tothadi/esp-heating-control/hardware/enclosure/drawings/inserts_drawing.pdf

0, 0

## ESP Heating Control – cover (cover.stl) – threaded inserts

VIEW FROM BOTTOM (open side of the cover). 8 × JLC3DP insert Type 5: M3*4*5 (M3, 5 mm long, OD 4.0 mm), hole Ø3.6 mm × 7 mm deep, already in the model. Inserts go into the end faces of the Ø9.8 mm bosses, flush with the face. Corner bosses (H, red): faces 3.6 mm inside the cover rim. Logic
board bosses (LB, purple): inside the nose, faces 38.0 mm deeper than the corner bosses. Positions in mm from the bottom-left corner of this view (0,
0).
H2 | H1

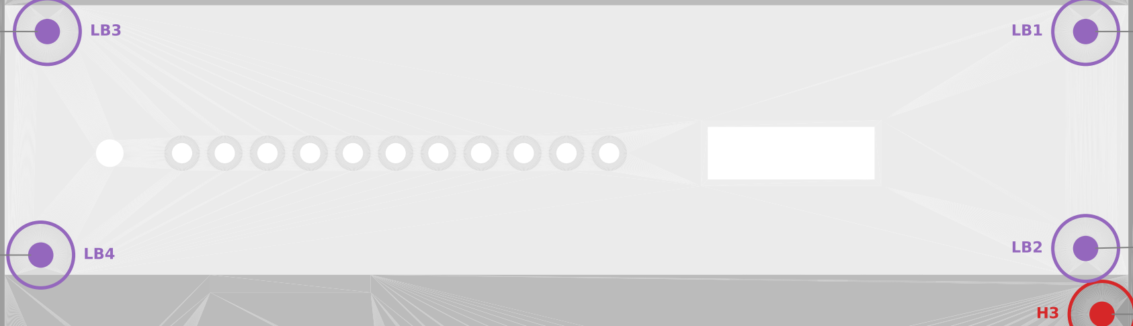
[picture p16: figure]

H4

H4: INSERT TYPE 5 (M3*4*5) corner boss
x 6.0 y 6.0

LB4: INSERT TYPE 5 (M3*4*5) logic board boss
x 7.5 y 27.5

LB3: INSERT TYPE 5 (M3*4*5) logic board boss
x 8.5 y 61.5

H2: INSERT TYPE 5 (M3*4*5) corner boss
x 6.0 y 84.0

H3: INSERT TYPE 5 (M3*4*5) corner boss
x 169.0 y 18.5

LB2: INSERT TYPE 5 (M3*4*5) logic board boss
x 166.5 y 28.5

LB1: INSERT TYPE 5 (M3*4*5) logic board boss
x 166.5 y 61.5

H1: INSERT TYPE 5 (M3*4*5) corner boss
x 169.0 y 84.0
