tothadi/esp-heating-control/hardware/enclosure/drawings/inserts_drawing.png

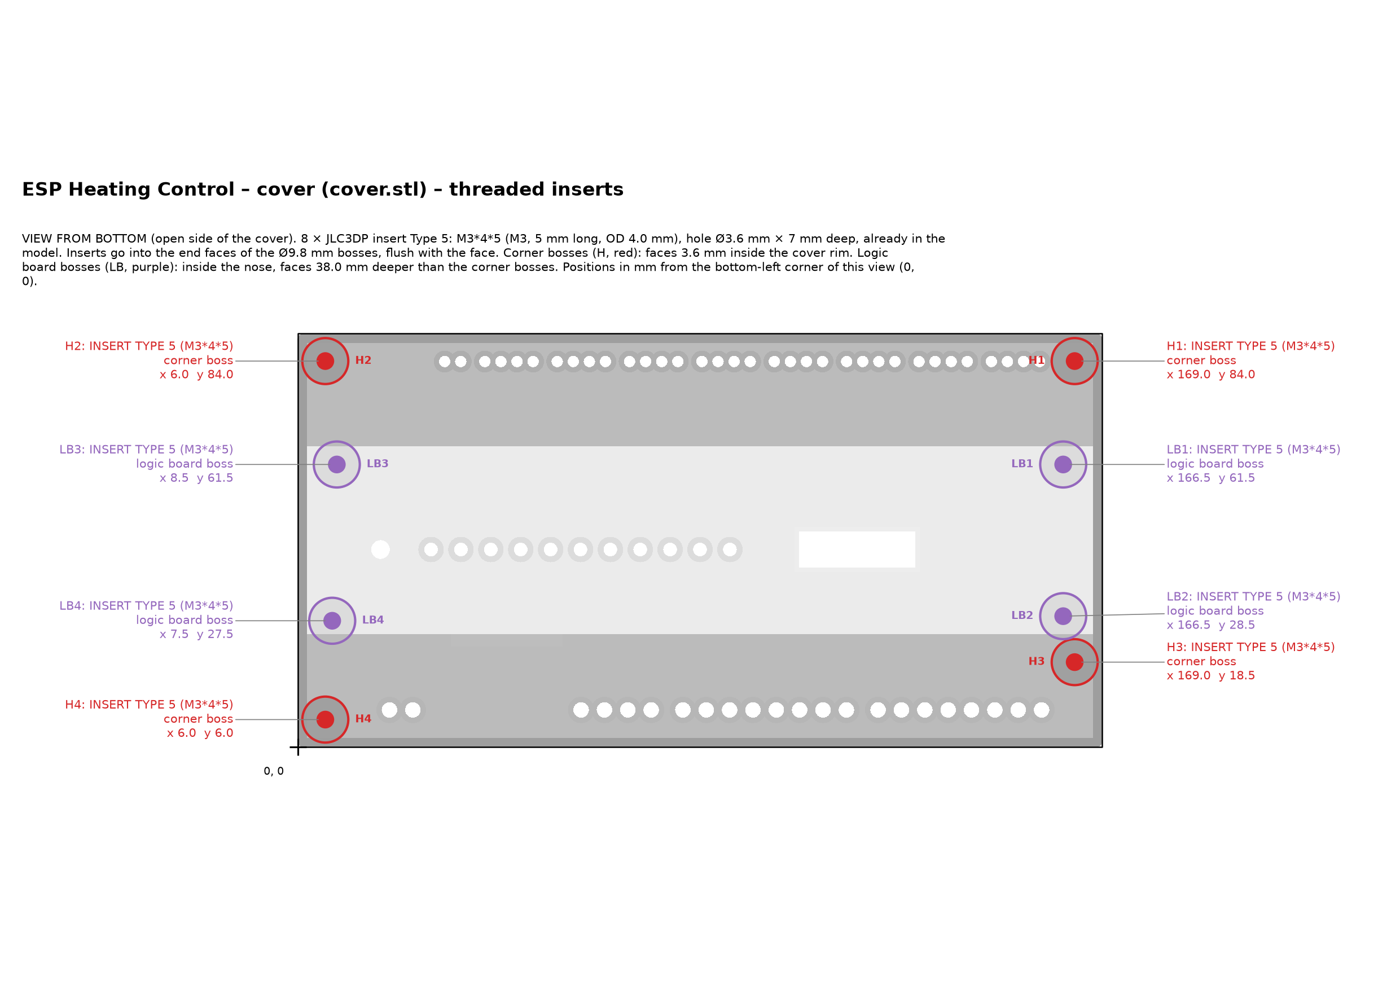
hardware/enclosure/drawings/inserts_drawing.png
