tothadi/esp-heating-control/hardware/renders/asm_boards_ffc_side.png

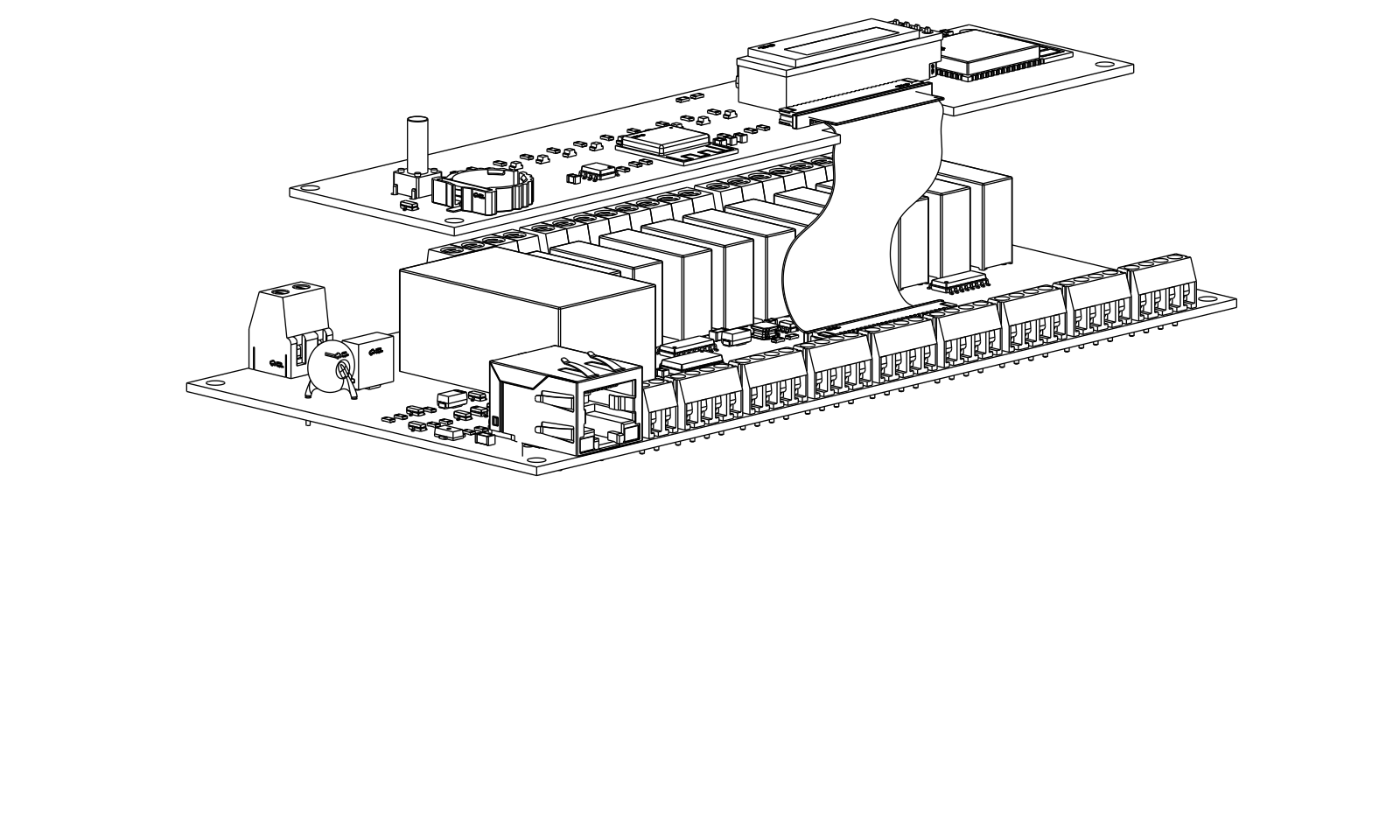
hardware/renders/asm_boards_ffc_side.png
