tothadi/esp-heating-control/hardware/renders/asm_closed_back.png

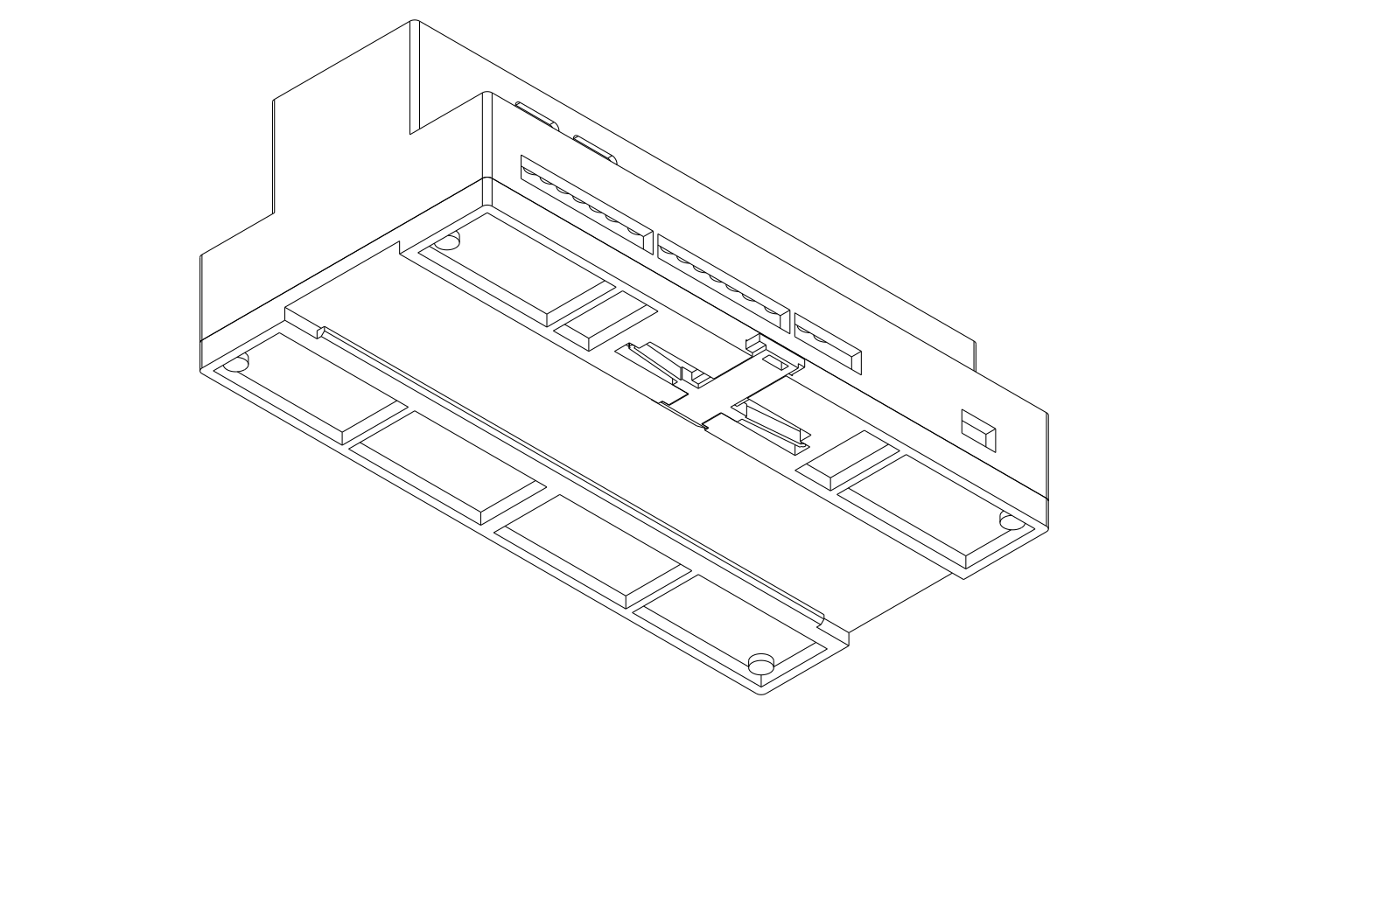
hardware/renders/asm_closed_back.png
