tothadi/esp-heating-control/hardware/renders/asm_closed_front.png

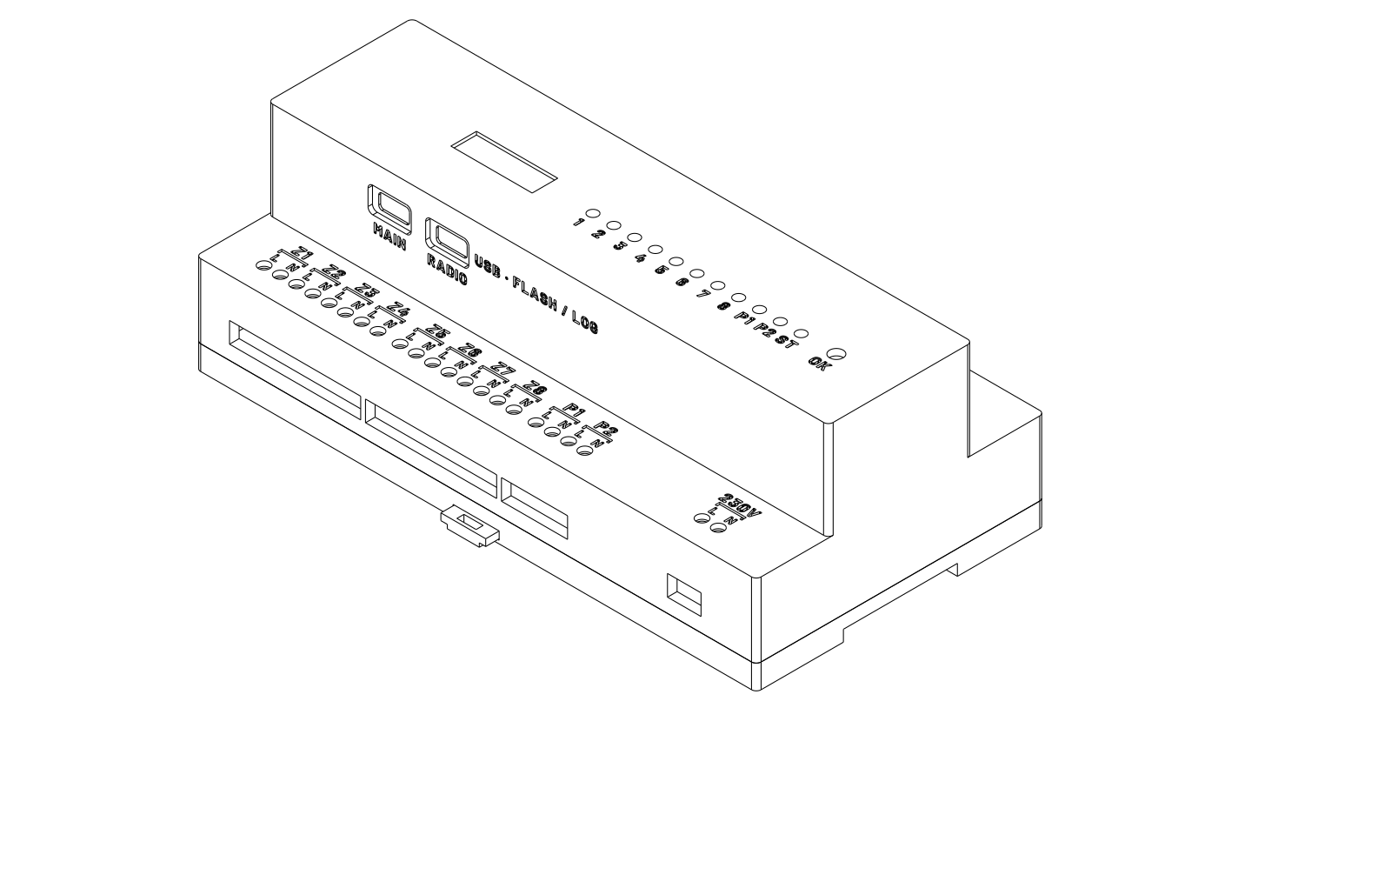
hardware/renders/asm_closed_front.png
