tothadi/esp-heating-control/hardware/renders/asm_closed_side.png

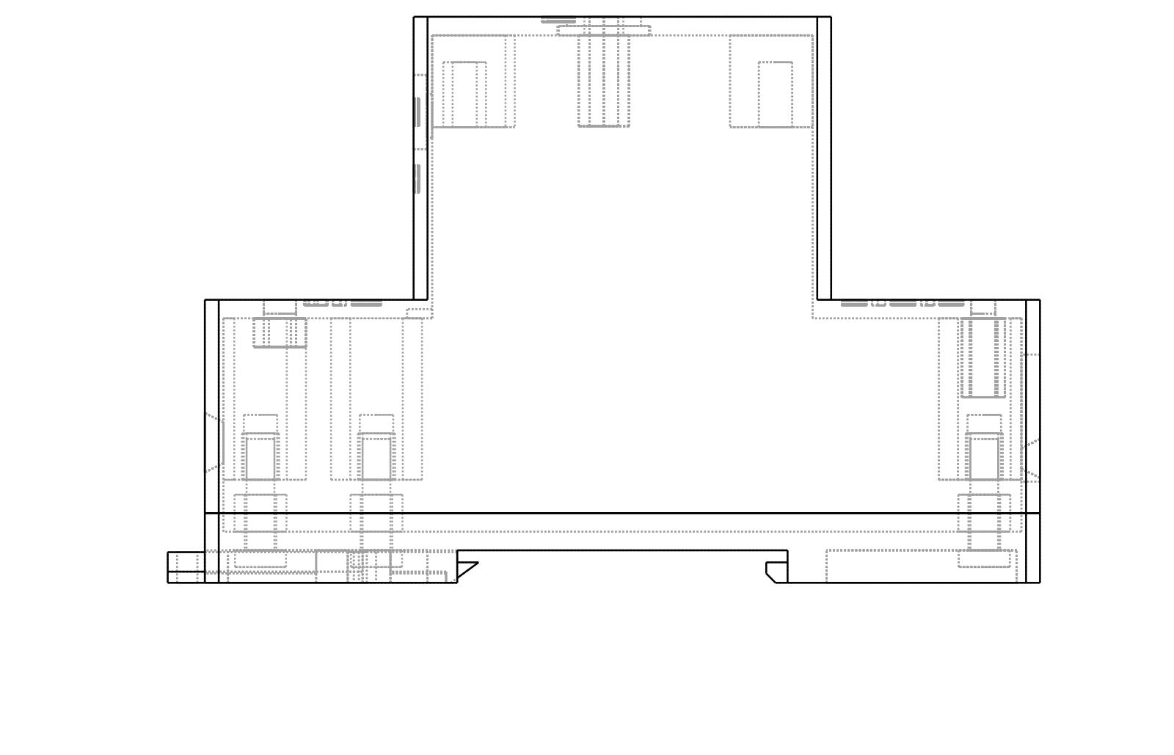
hardware/renders/asm_closed_side.png
