tothadi/esp-heating-control/hardware/renders/asm_closed_top.png

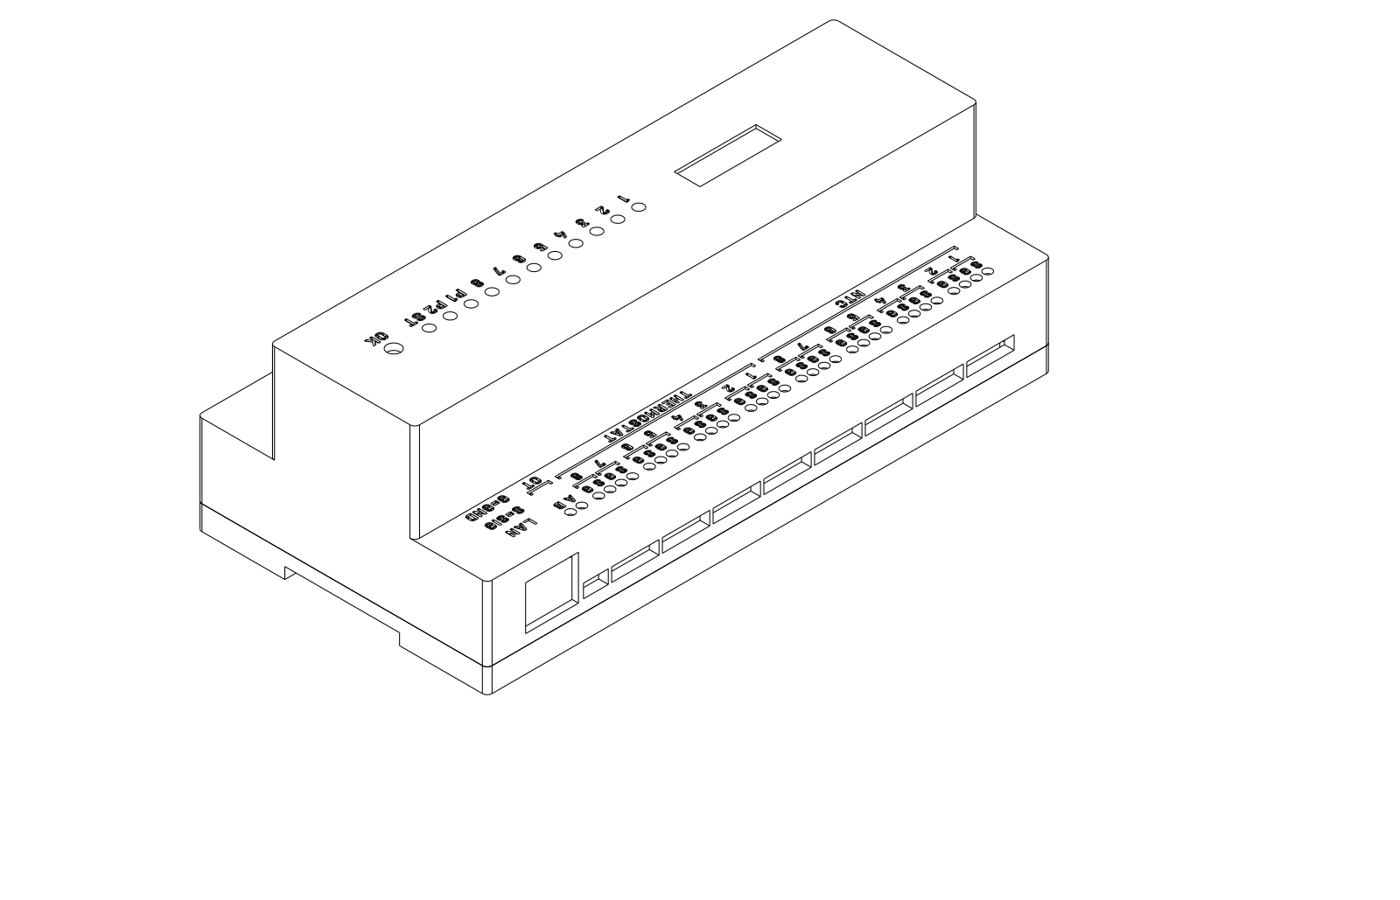
hardware/renders/asm_closed_top.png
