tothadi/esp-heating-control/hardware/renders/asm_din_section.png

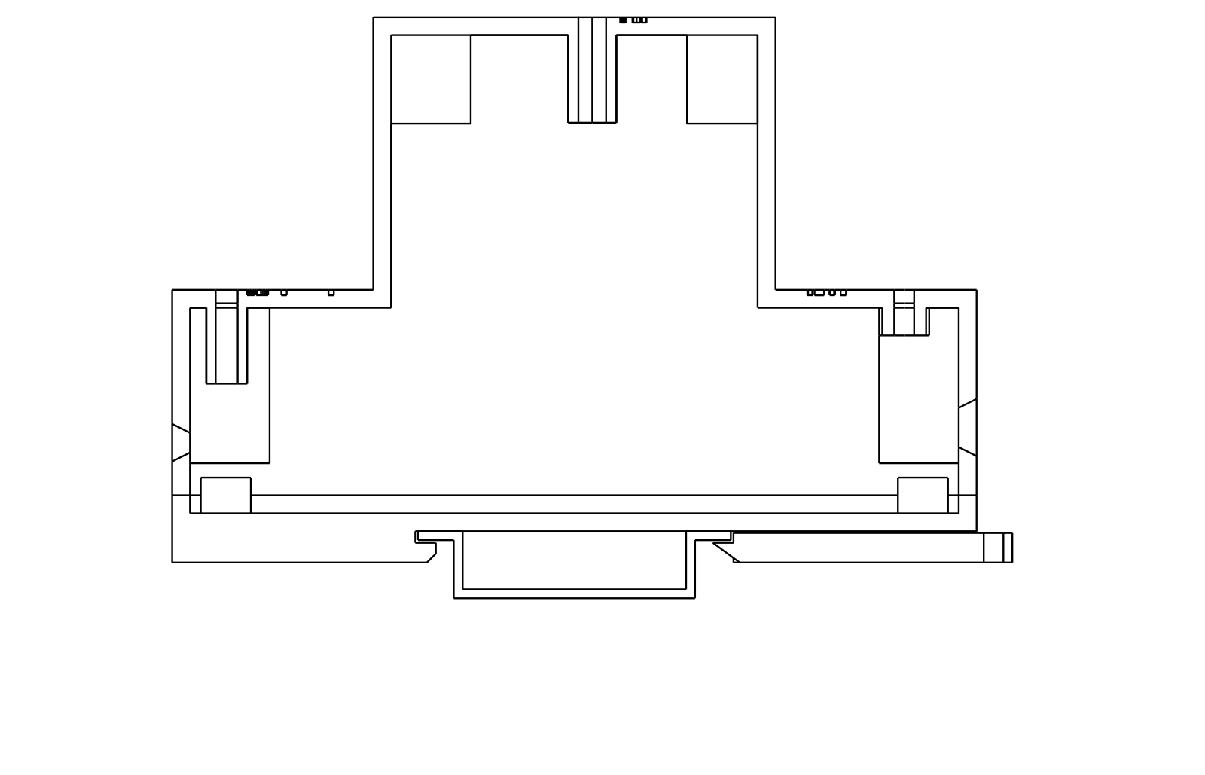
hardware/renders/asm_din_section.png
