tothadi/esp-heating-control/hardware/renders/asm_din_slider.png

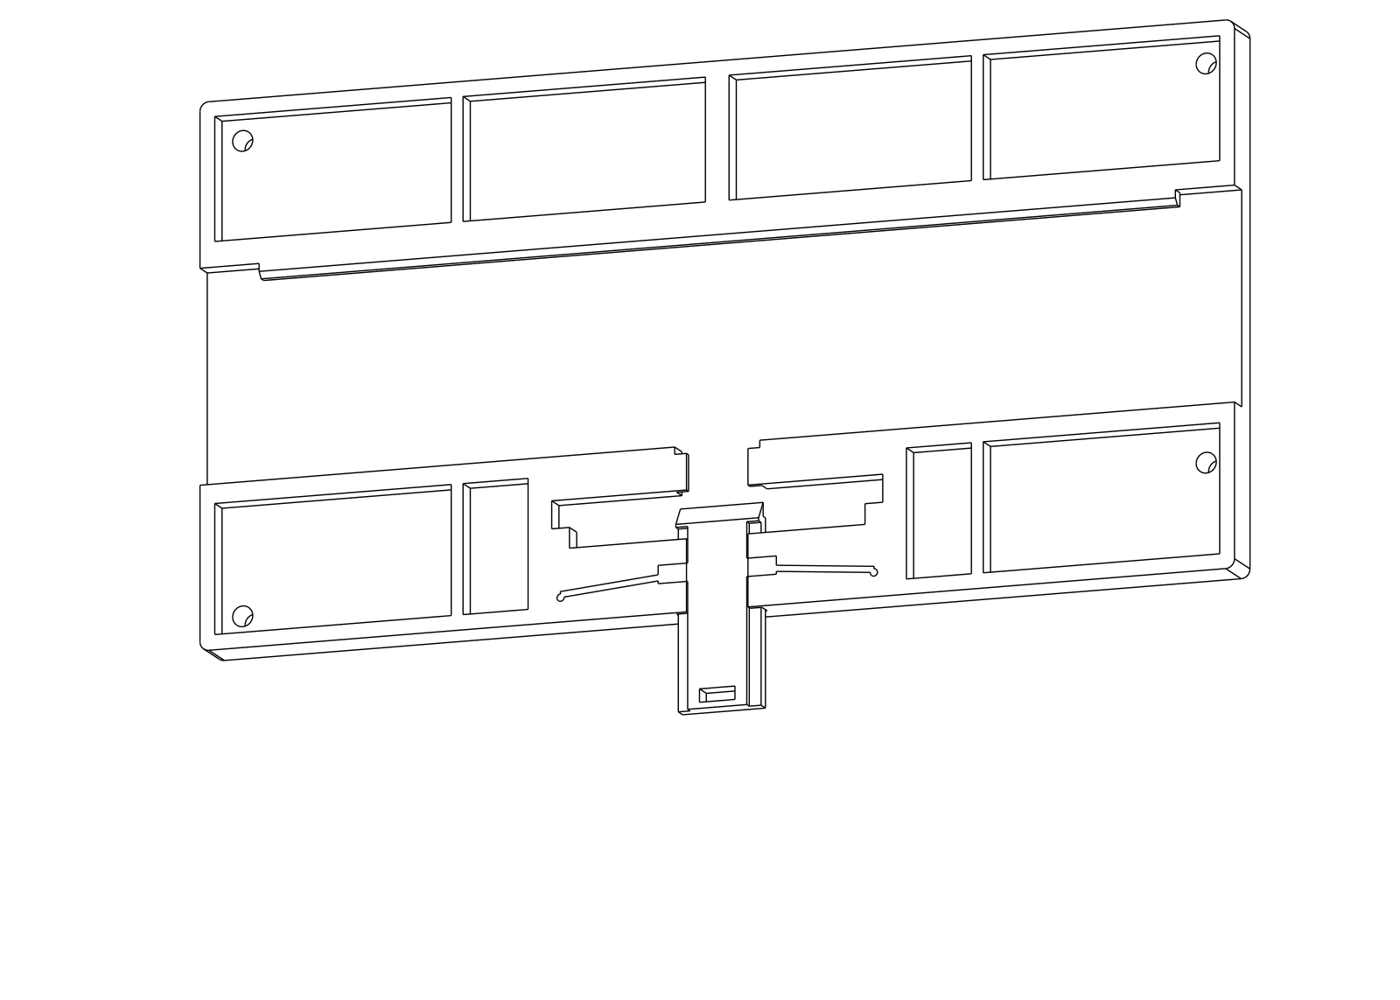
hardware/renders/asm_din_slider.png
