tothadi/esp-heating-control/hardware/renders/asm_led_section.png

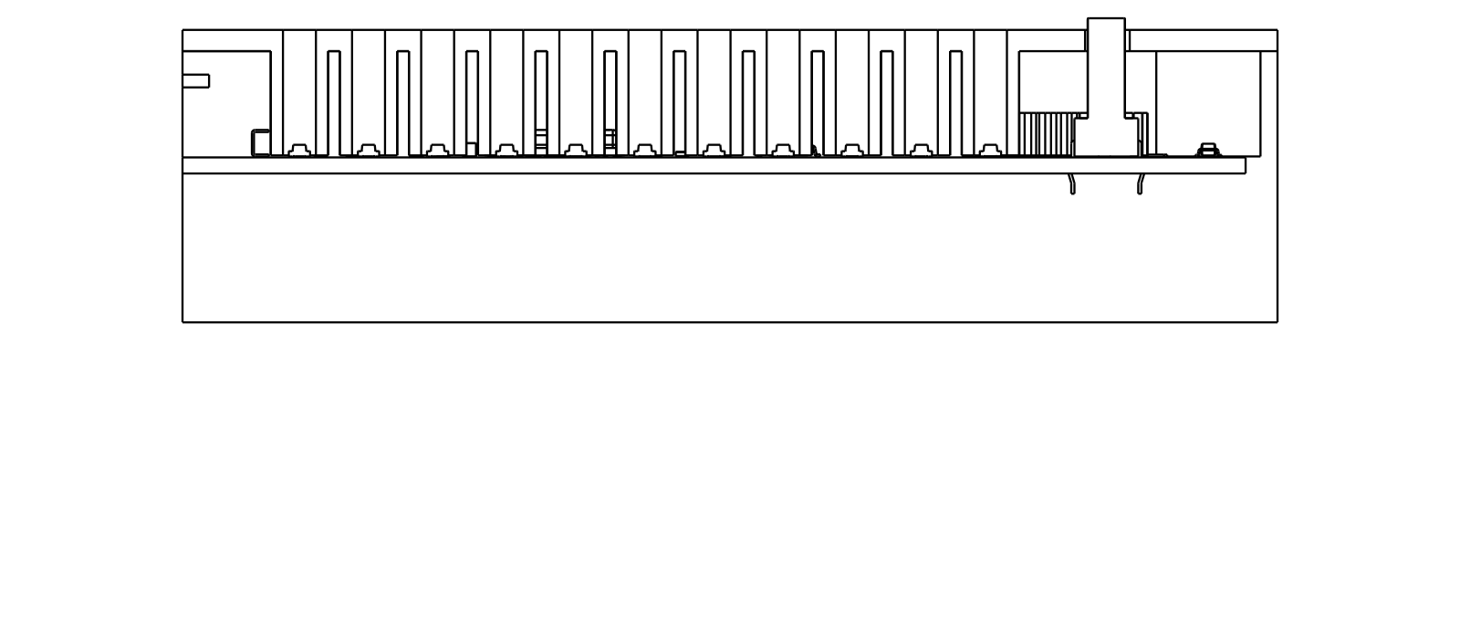
hardware/renders/asm_led_section.png
