tothadi/esp-heating-control/hardware/renders/asm_oled_section.png

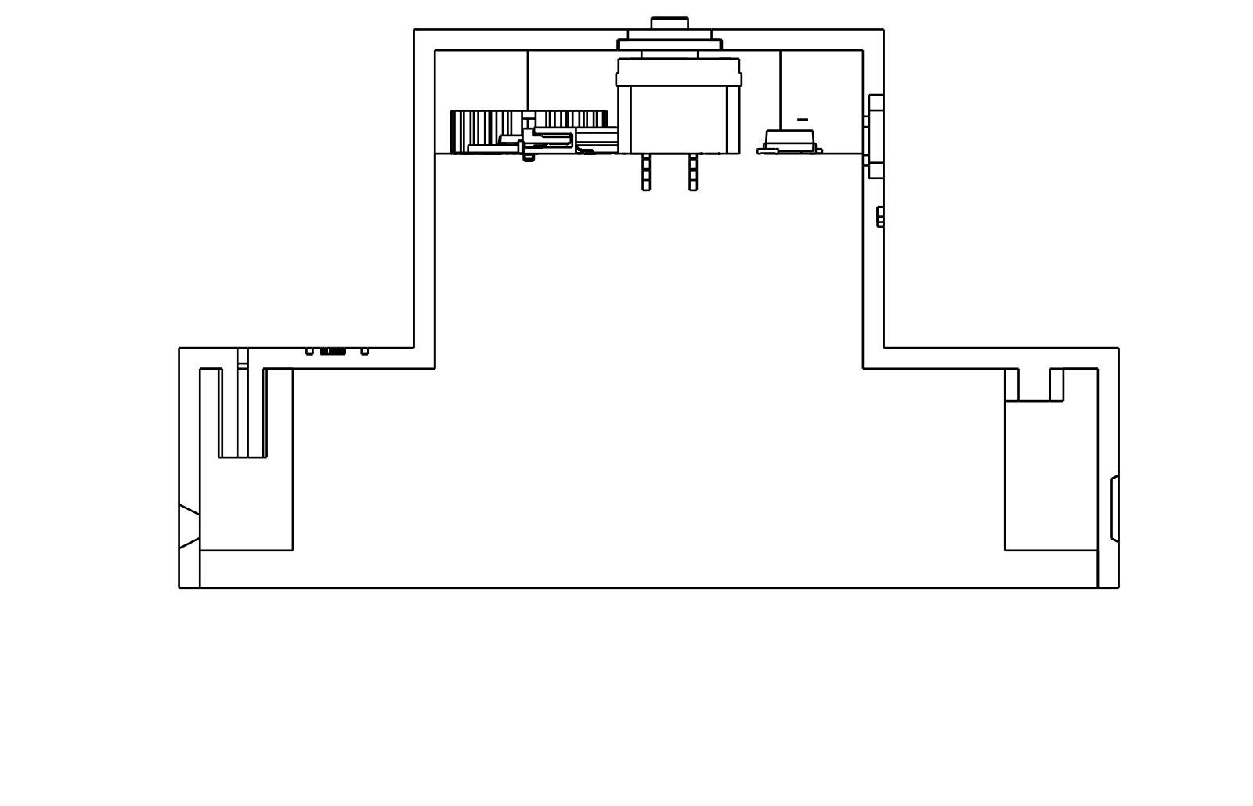
hardware/renders/asm_oled_section.png
