tothadi/esp-heating-control/hardware/renders/logic_bottom.png

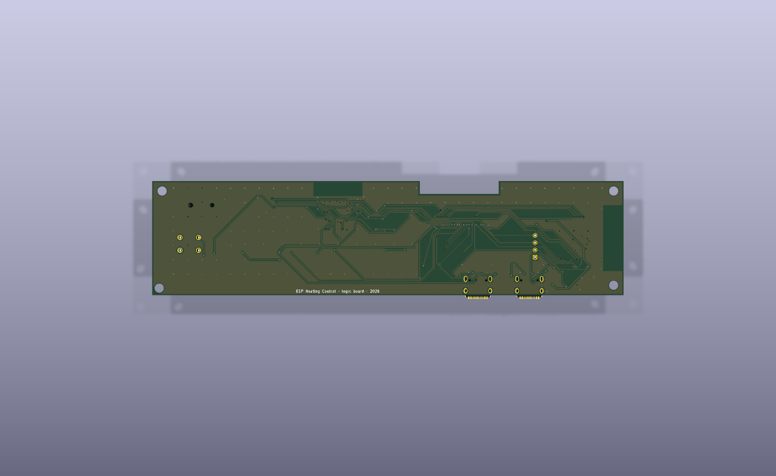
hardware/renders/logic_bottom.png
