tothadi/esp-heating-control/hardware/renders/logic_iso_bottom.png

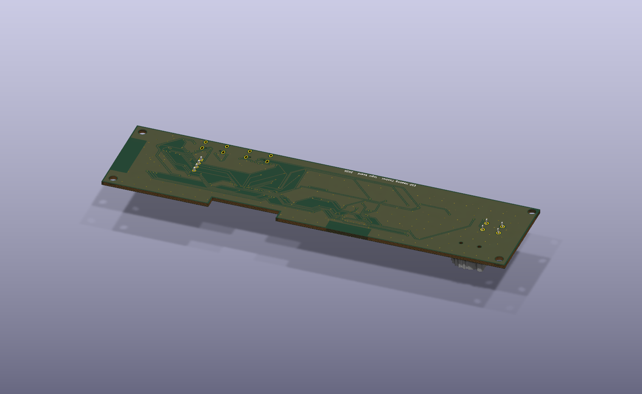
hardware/renders/logic_iso_bottom.png
