tothadi/esp-heating-control/hardware/renders/lower_bottom.png

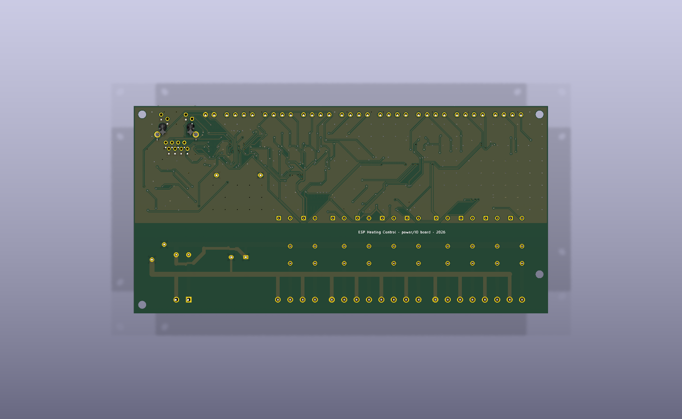
hardware/renders/lower_bottom.png
