tothadi/esp-heating-control/hardware/renders/lower_iso_back.png

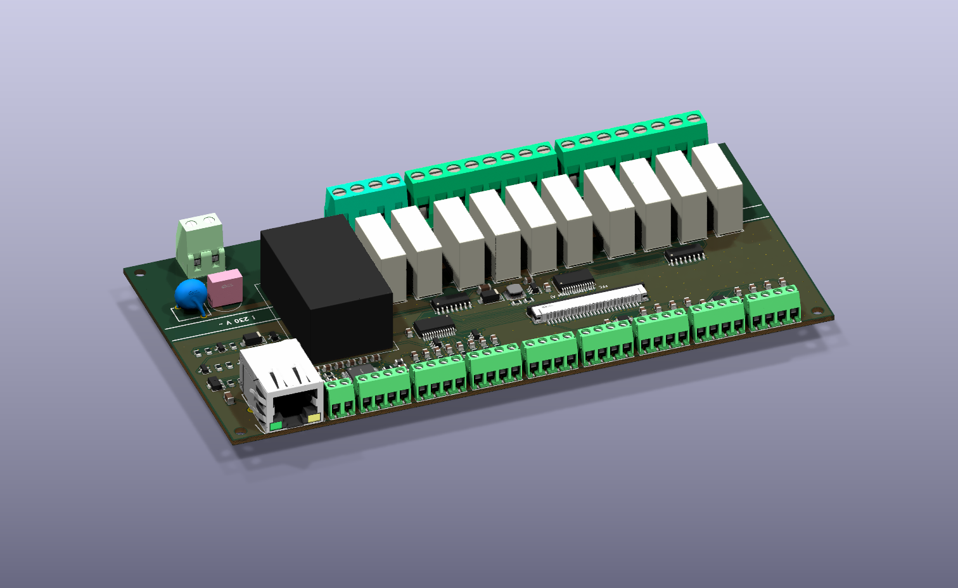
hardware/renders/lower_iso_back.png
