tothadi/esp-heating-control/hardware/pcb/logic/fab/jlcpcb_bom.csv

Comment | Designator | Footprint | LCSC Part #
BS-12-B2AA002 (CR1220) | BT1 | BS-12 | C964721
10uF 25V X5R | C40,C41,C48 | C_0805 | C15850
100nF 50V X7R | C43,C45,C49 | C_0805 | C49678
1uF 50V X7R | C44,C50 | C_0805 | C28323
22uF 25V X5R | C47 | C_0805 | C45783
SS34 | D1,D2 | D_SMA | C8678
BAT54S | D14 | SOT-23 | C7420333
LED green 0805 | D20,D21,D22,D23,D24,D25,D26,D27 | LED_0805 | C2297
LED yellow 0805 | D28,D29 | LED_0805 | C2296
LED red 0805 | D30 | LED_0805 | C84256
AFA07-S26FCA-00 FFC 26P 1.0mm | J1 | JUSHUO_AFA07-S26FCA-00 | C2681942
TYPE-C-31-M-12 | J2,J4 | USB-C-16P | C165948
PZ254V-11-04P pin header 1x4 2.54mm (OLED) | J3 | HDR-1x4-P2.54-V | C492403
4.7k 1% | R9,R10,R28,R29 | R_0805 | C17673
10k 1% | R17,R19,R20,R25,R26,R27 | R_0805 | C17414
5.1k 1% | R21,R22,R23,R24 | R_0805 | C27834
330R 1% | R50,R51,R52,R53,R54,R55,R56,R57,R58,R59,R60 | R_0805 | C17630
KH-6X6X13H-TJ | SW1 | 6x6 H13 | C2837523
ESP32-S3-WROOM-1-N16R8 | U1 | ESP32-S3-WROOM-1 | C2913202
AMS1117-3.3 | U2 | SOT-223 | C6186
DS3231MZ+TRL | U6 | SOIC-8 | C107410
ESP32-H2-MINI-1-H4S | U7 | ESP32-H2-MINI-1 | C47967030
