tothadi/esp-heating-control/hardware/pcb/lower/fab/jlcpcb_bom.csv

Comment | Designator | Footprint | LCSC Part #
100nF 50V X7R | C1,C4,C11,C19,C29,C30,C31,C32,C33,C34,C35,C36,C37,C73,C77,C80,C81,C82 | C_0805_2012Metric | C49678
10uF 25V X5R | C10,C21,C22,C23,C24,C25,C26,C27,C28,C40,C85 | C_0805_2012Metric | C15850
220uF 16V 6.3x7.7 (RVT1C221M0607) | C12 | CP_Elec_6.3x7.7 | C970695
10uF 50V X5R 1206 | C41 | C_1206 | C13585
22nF X7R 50V | C70 | C_0805 | C1729
6.8nF X7R 50V | C71,C72 | C_0805 | C1755
1nF 2kV X7R 1206 | C74 | C_1206 | C9196
18pF C0G 50V | C75,C76 | C_0805 | C1797
10nF X7R 50V | C83 | C_0805 | C1710
4.7uF X5R 25V | C84 | C_0805 | C1779
SS34 | D20 | D_SMA | C8678
BZT52C4V3 | D21 | SOD-123 | C19077399
BAT54S | D22,D23 | SOT-23 | C7420333
SMAJ24A | D24 | D_SMA | C19077541
T2A 250V TR5 (2010T2A250V) | F1 | Fuse_Littelfuse_372_D8.50mm | C354902
Ferrite 600R@100MHz 500mA | FB1 | 0805 | C1017
XY350V-3.5-4P screw terminal | J1,J2,J3,J4,J5,J6,J7,J8 | XY350V-3.5-4P | C557656
XY350V-3.5-2P screw terminal | J9 | XY350V-3.5-2P | C784942
DB128V-5.08-8P-GN-S screw terminal | J21,J22 | DB128V-5.08-8P | C5143711
DB128V-5.08-4P-GN-S screw terminal | J23 | DB128V-5.08-4P | C2915641
DB128V-5.08-2P-GN-S screw terminal | J24 | DB128V-5.08-2P | C2915639
AFA07-S26FCA-00 FFC 26P 1.0mm | J30 | JUSHUO_AFA07-S26FCA-00 | C2681942
J1B1211CCD RJ45 10/100 magjack | J40 | RJ45-TH_J1B1211CCD | C910371
G5NB-1A-E-DC5V | K1,K2,K3,K4,K5,K6,K7,K8,K9,K10 | Relay_SPST_Omron_G5NB | C48746
22uH SWPA4030S220MT | L1 | 4x4 | C83472
HLK-5M05 | PS1 | Converter_ACDC_Hi-Link_HLK-5Mxx | C209907
BCX56-16,115 (Nexperia) | Q1 | SOT-89 | C100026
MMBT3904 | Q2,Q3,Q4 | SOT-23 | C20526
10k 0.1% | R21,R22,R23,R24,R25,R26,R27,R28 | R_0805 | C110775
1k 1% | R30,R31,R32,R33,R34,R35,R36,R37,R40,R41,R42,R43,R44,R45,R46,R47,R56,R59 | R_0805 | C17513
390k 1% | R50 | R_0805 | C17656
10k 1% | R51,R54,R57,R84 | R_0805 | C17414
2.2k 1% 1206 | R52 | R_1206 | C17948
68k 1% | R53 | R_0805 | C17801
15R 1% | R55 | R_0805 | C17480
47R 1% | R58 | R_0805 | C17714
4.7k 1% | R60 | R_0805 | C17673
3.3R 1% | R70,R71,R75,R76 | R_0805 | C2907250
49.9R 1% | R72,R73,R77,R78 | R_0805 | C17720
10R 1% | R74 | R_0805 | C17415
12.4k 1% | R79 | R_0805 | C30908
470R 1% | R80,R81 | R_0805 | C17710
1M 1% | R82 | R_0805 | C17514
0R | R83 | R_0805 | C17477
07D471K | RV1 | RES-TH_L9.0-W6.2-P5.00-D0.7-S6.20 | C28756
MCP23017-E/SS | U1,U14 | SSOP-28_5.3x10.2mm_P0.65mm | C506653
ULN2003A | U2,U3 | SOIC-16_3.9x9.9mm_P1.27mm | C688859
ADS1115IDGSR | U10,U11 | MSOP-10 | C37593
SRV05-4 | U12,U13 | SOT-23-6 | C13612
MT3608 | U20 | SOT-23-6 | C84817
CJ431 | U21 | SOT-23 | C3113
W5500 | U30 | LQFP-48 | C32843
25MHz 12pF X322525MOB4SI | Y30 | 3225 | C9006
