tothadi/esp-heating-control/hardware/enclosure/models/cover.stl

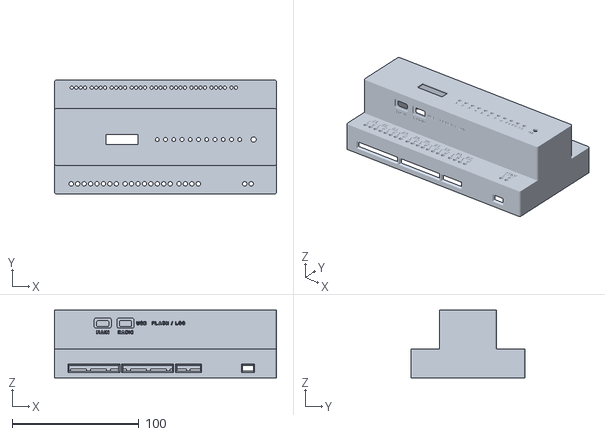
[picture p31: CAD file, 2026-11-10]
hardware/enclosure/models/cover.stl
175.0 x 90.0 x 53.5
