tothadi/esp-heating-control/hardware/pcb/components/3d-models/LQFP-48_L7.0-W7.0-H1.4-LS9.0-P0.50.step

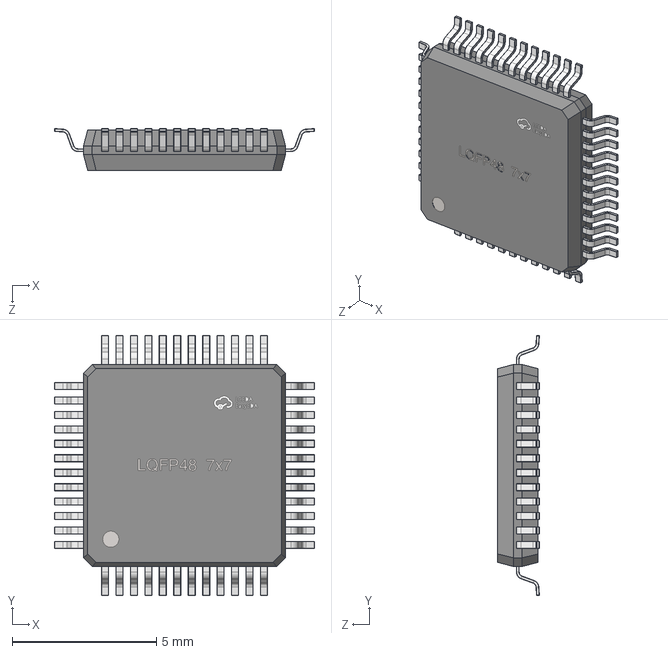
[picture p32: CAD file, 2026-11-10]
hardware/pcb/components/3d-models/LQFP-48_L7.0-W7.0-H1.4-LS9.0-P0.50.step
9.01 x 9.01 x 1.45 mm
