tothadi/esp-heating-control/hardware/enclosure/models/oled_window.dxf

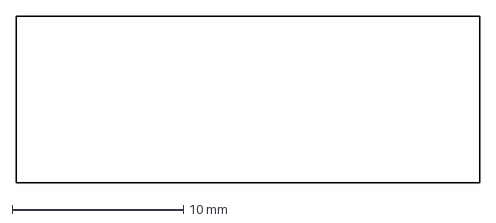
[picture p33: CAD file, 2026-11-10]
hardware/enclosure/models/oled_window.dxf
27.1 x 9.70 mm
