tothadi/esp-heating-control/hardware/pcb/components/3d-models/RJ45-TH_J1B1211CCD.step

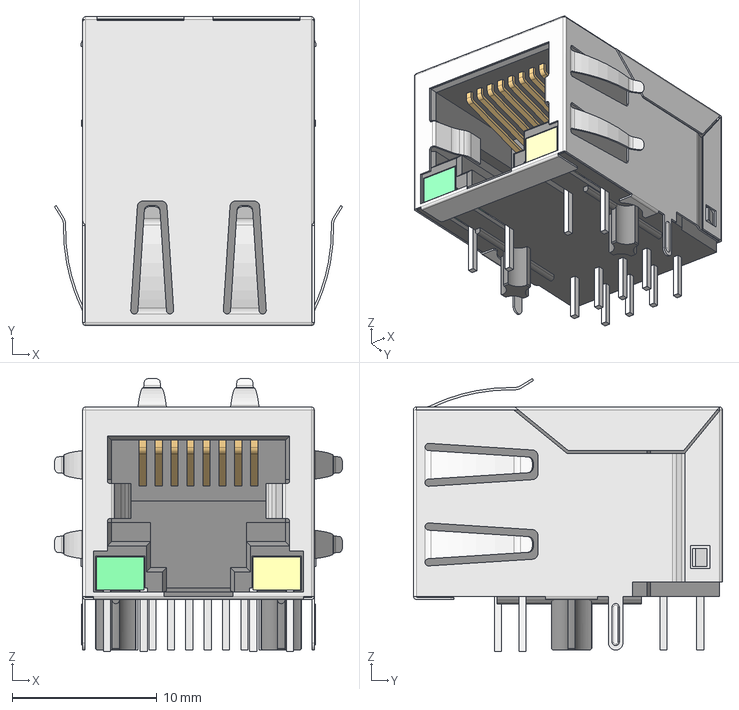
[picture p34: CAD file, 2026-11-10]
hardware/pcb/components/3d-models/RJ45-TH_J1B1211CCD.step
19.9 x 21.4 x 18.9 mm
