tothadi/esp-heating-control/hardware/enclosure/models/base.stl

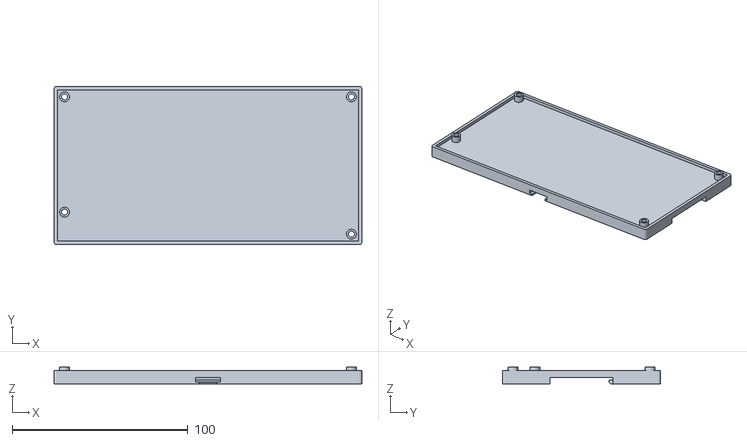
[picture p35: CAD file, 2026-11-10]
hardware/enclosure/models/base.stl
175.0 x 90.0 x 9.50
