tothadi/esp-heating-control/hardware/pcb/components/3d-models/FUSE-TH_L8.5-W4.0-H8.5-P5.08.step

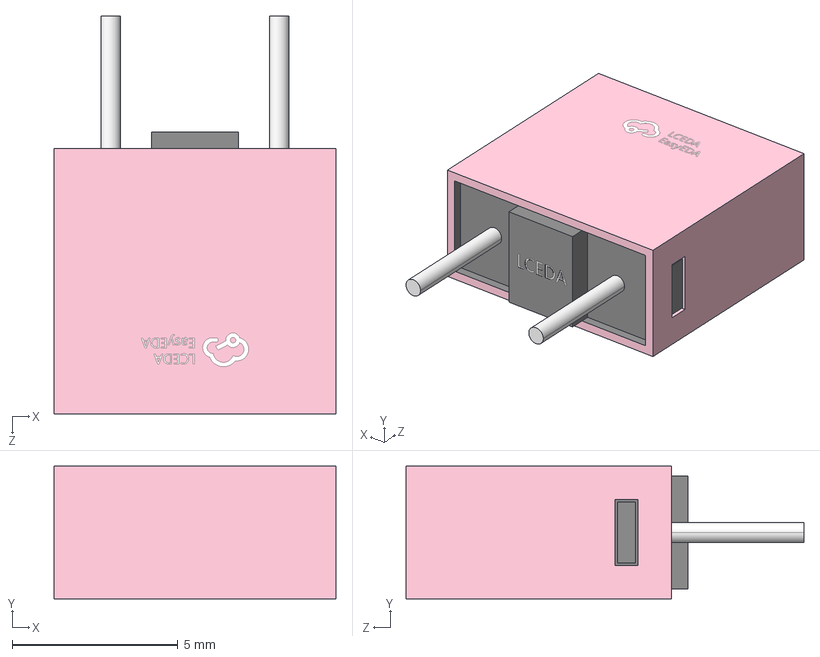
[picture p36: CAD file, 2026-11-10]
hardware/pcb/components/3d-models/FUSE-TH_L8.5-W4.0-H8.5-P5.08.step
8.50 x 4.00 x 12.0 mm
