tothadi/esp-heating-control/hardware/enclosure/models/led_rods.stl

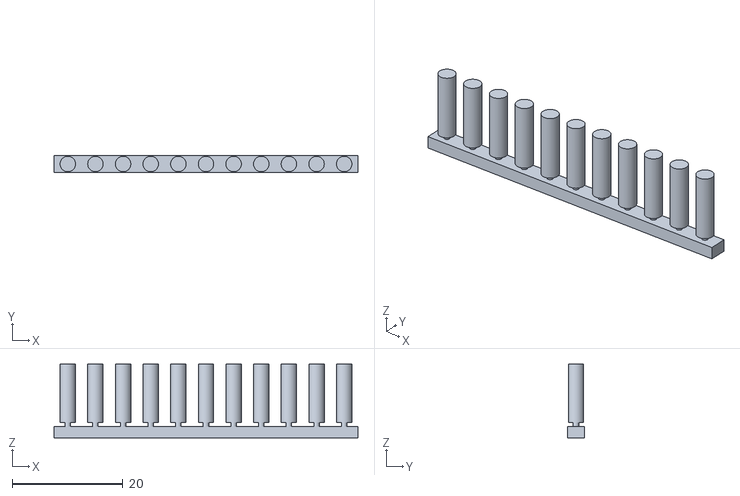
[picture p37: CAD file, 2026-11-10]
hardware/enclosure/models/led_rods.stl
55.0 x 3.00 x 13.3
