tothadi/esp-heating-control/hardware/pcb/components/3d-models/RES-TH_L9.0-W6.2-P5.00-D0.7-S6.20.step

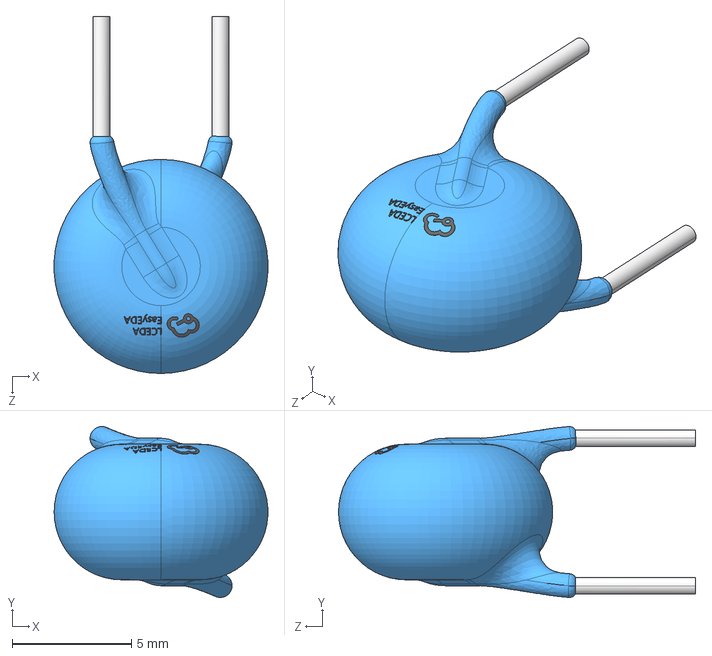
[picture p38: CAD file, 2026-11-10]
hardware/pcb/components/3d-models/RES-TH_L9.0-W6.2-P5.00-D0.7-S6.20.step
8.98 x 7.19 x 15.0 mm
