tothadi/esp-heating-control/hardware/enclosure/models/enclosure.step

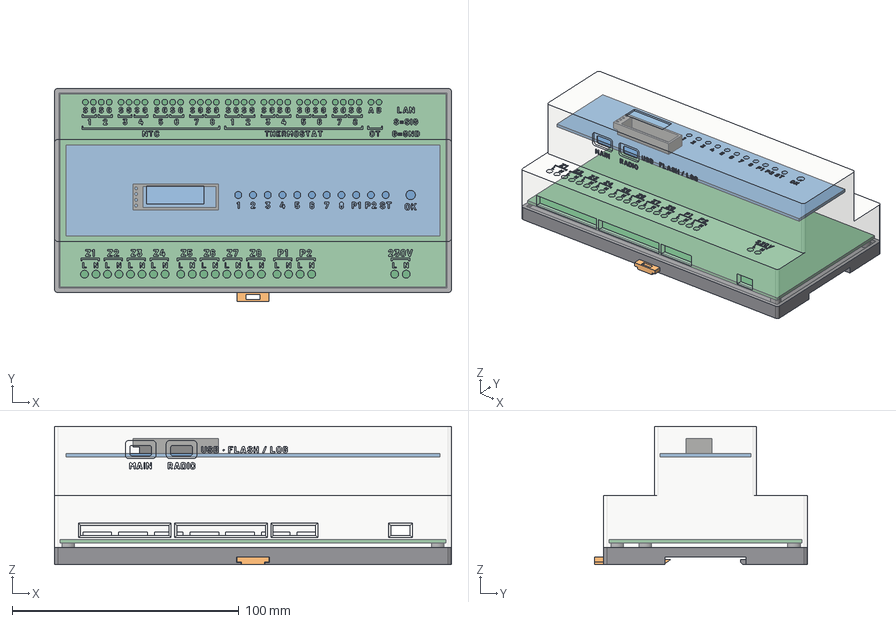
[picture p39: CAD file, 2026-11-10]
hardware/enclosure/models/enclosure.step
175.0 x 94.0 x 61.0 mm
base
din_slider
oled_spacer
oled_window
cover
lower_pcb
upper_pcb
