tothadi/esp-heating-control/hardware/pcb/components/3d-models/CRYSTAL-SMD_4P-L3.2-W2.5-BL.step

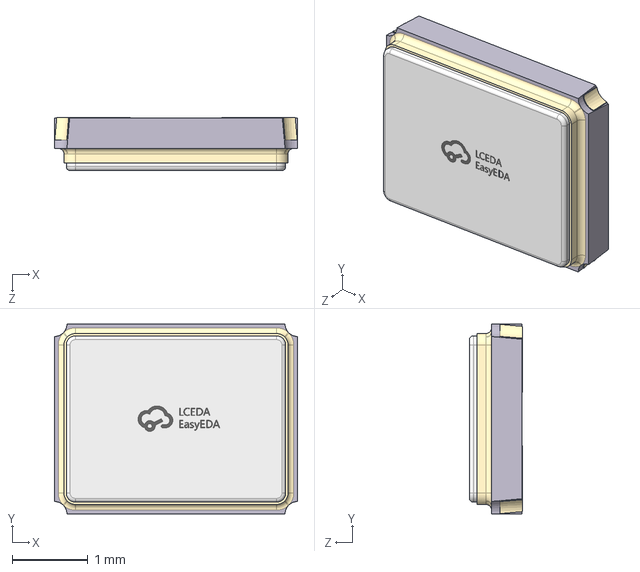
[picture p40: CAD file, 2026-11-10]
hardware/pcb/components/3d-models/CRYSTAL-SMD_4P-L3.2-W2.5-BL.step
3.20 x 2.50 x 0.701 mm
