tothadi/esp-heating-control/hardware/enclosure/models/oled_spacer.stl

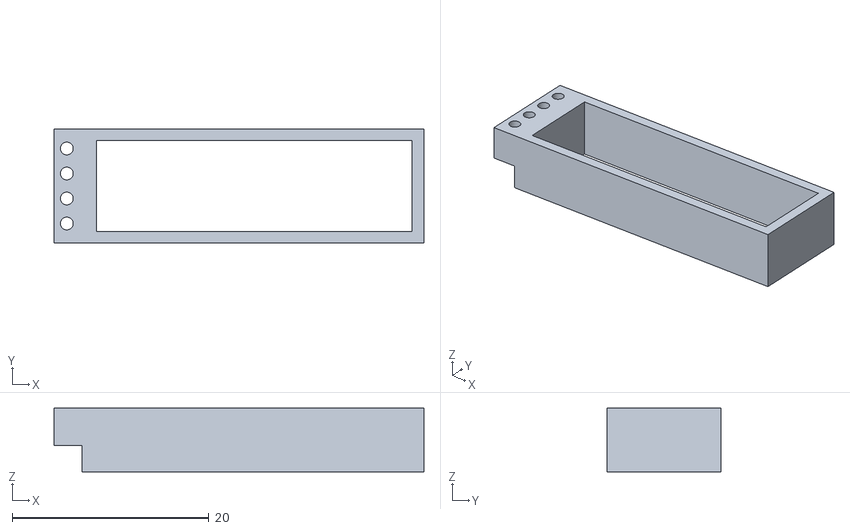
[picture p41: CAD file, 2026-11-10]
hardware/enclosure/models/oled_spacer.stl
37.6 x 11.6 x 6.50
