tothadi/esp-heating-control/hardware/pcb/components/3d-models/WIRELM-SMD_ESP32-H2-MINI-1-H4.step

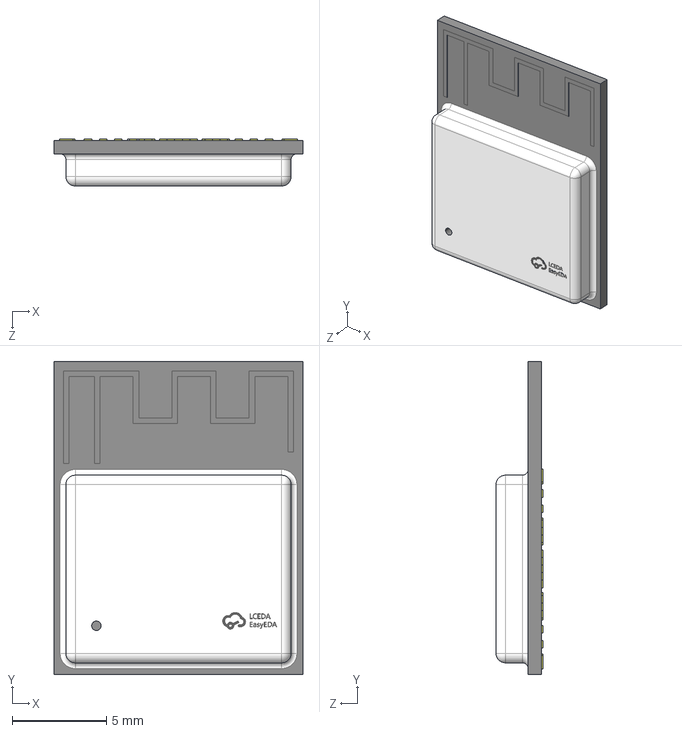
[picture p42: CAD file, 2026-11-10]
hardware/pcb/components/3d-models/WIRELM-SMD_ESP32-H2-MINI-1-H4.step
13.2 x 16.6 x 2.51 mm
