tothadi/esp-heating-control/hardware/enclosure/models/din_slider.stl

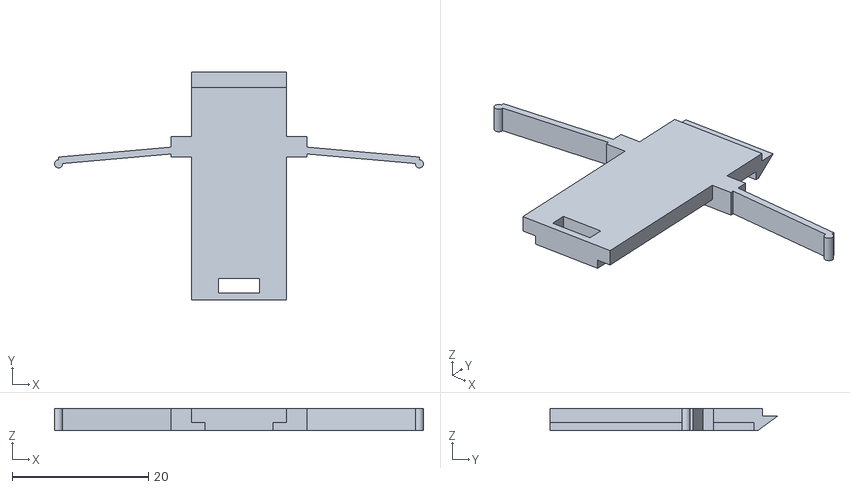
[picture p43: CAD file, 2026-11-10]
hardware/enclosure/models/din_slider.stl
54.2 x 33.5 x 3.30
