tothadi/esp-heating-control/hardware/pcb/components/3d-models/IDC-TH_26P-P2.54_C9040.step

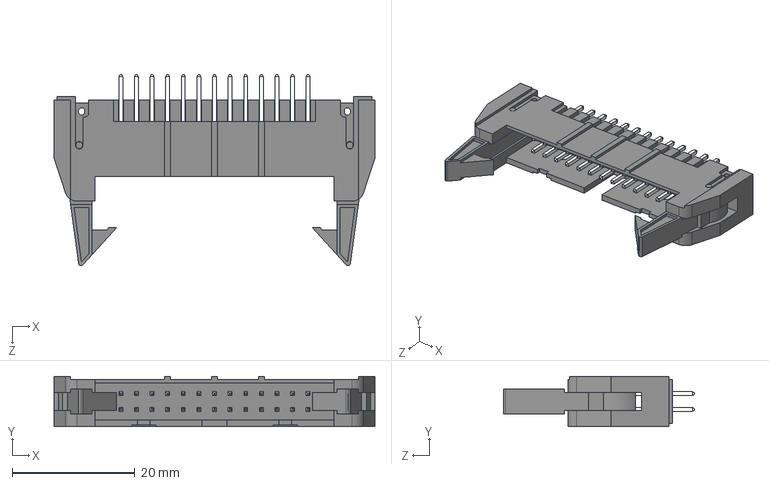
[picture p44: CAD file, 2026-11-10]
hardware/pcb/components/3d-models/IDC-TH_26P-P2.54_C9040.step
52.2 x 8.20 x 31.2 mm
