tothadi/esp-heating-control/hardware/pcb/components/3d-models/BAT-SMD_L28.5-W16.0-H5.5-LS31.3_CR2032-BS-6-1.step

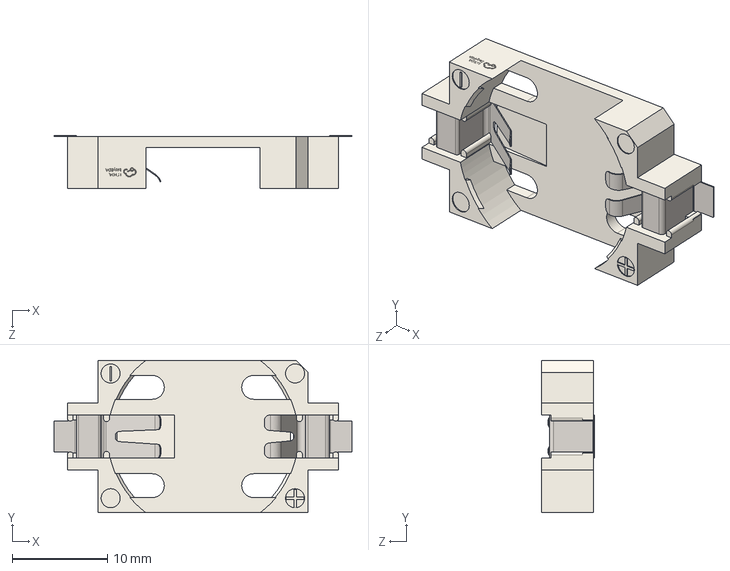
[picture p45: CAD file, 2026-11-10]
hardware/pcb/components/3d-models/BAT-SMD_L28.5-W16.0-H5.5-LS31.3_CR2032-BS-6-1.step
31.3 x 16.0 x 5.60 mm
