tothadi/esp-heating-control/hardware/pcb/components/3d-models/CONN-TH_8P-P5.08_KF2EDGR-5.08-8P.step

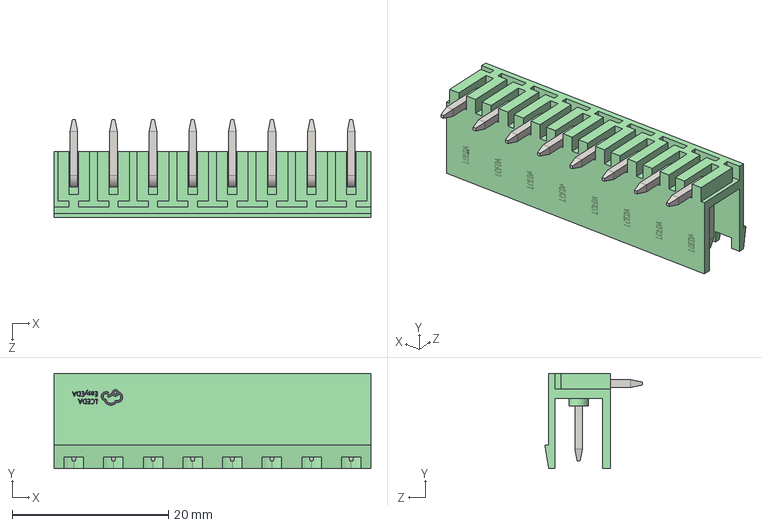
[picture p46: CAD file, 2026-11-10]
hardware/pcb/components/3d-models/CONN-TH_8P-P5.08_KF2EDGR-5.08-8P.step
40.6 x 12.2 x 12.5 mm
