tothadi/esp-heating-control/hardware/pcb/components/3d-models/USB-C_SMD-TYPE-C-31-M-12_1.step

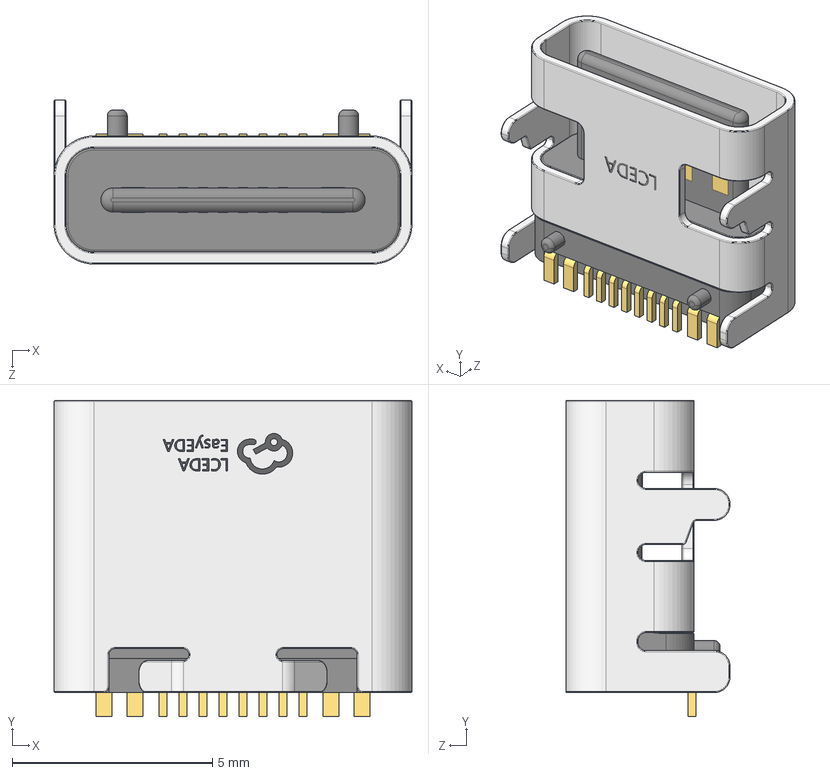
[picture p47: CAD file, 2026-11-10]
hardware/pcb/components/3d-models/USB-C_SMD-TYPE-C-31-M-12_1.step
8.94 x 7.90 x 4.10 mm
