tothadi/esp-heating-control/hardware/pcb/components/3d-models/CONN-TH_XY350V-3.5-4P.step

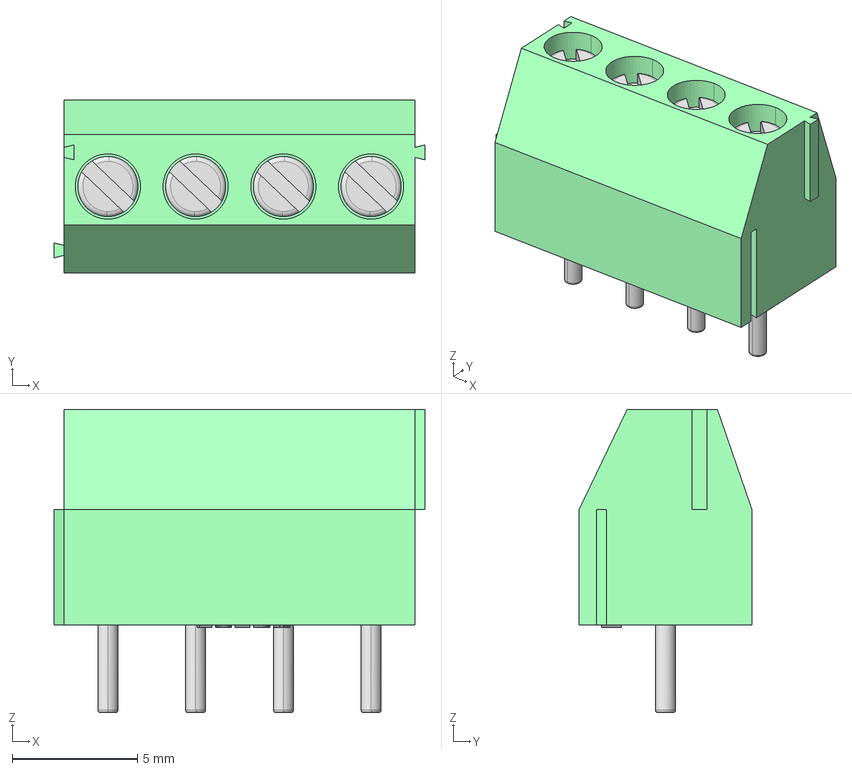
[picture p48: CAD file, 2026-11-10]
hardware/pcb/components/3d-models/CONN-TH_XY350V-3.5-4P.step
14.8 x 6.90 x 12.1 mm
