tothadi/esp-heating-control/hardware/pcb/components/3d-models/SW-TH_4P-L6.0-W6.0-H5.0-LS6.5-P4.50.step

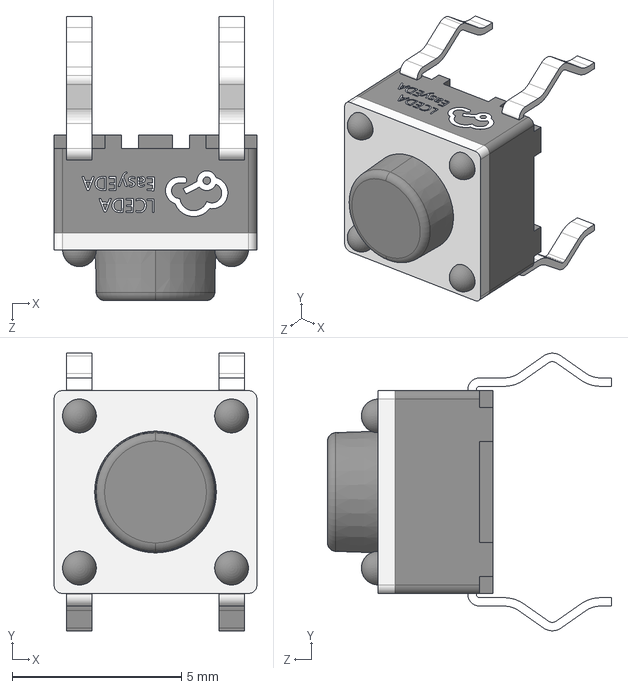
[picture p49: CAD file, 2026-11-10]
hardware/pcb/components/3d-models/SW-TH_4P-L6.0-W6.0-H5.0-LS6.5-P4.50.step
6.00 x 8.21 x 8.40 mm
