tothadi/esp-heating-control/hardware/pcb/components/3d-models/BAT-SMD_BS-12-B2AA002.step

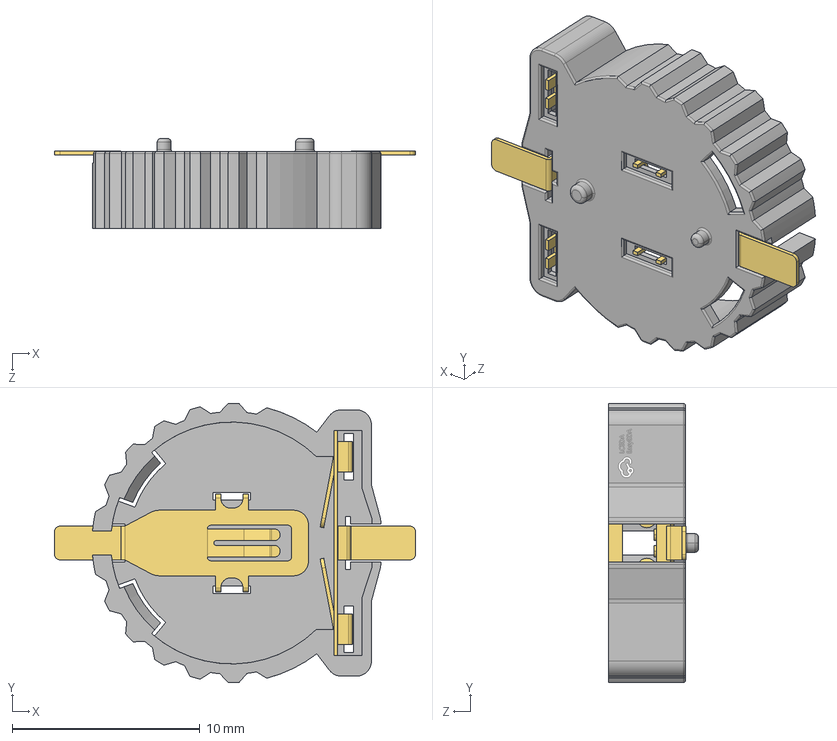
[picture p50: CAD file, 2026-11-10]
hardware/pcb/components/3d-models/BAT-SMD_BS-12-B2AA002.step
19.3 x 14.9 x 4.80 mm
