tothadi/esp-heating-control/hardware/pcb/components/3d-models/HDR-TH_4P-P2.54-V-F.step

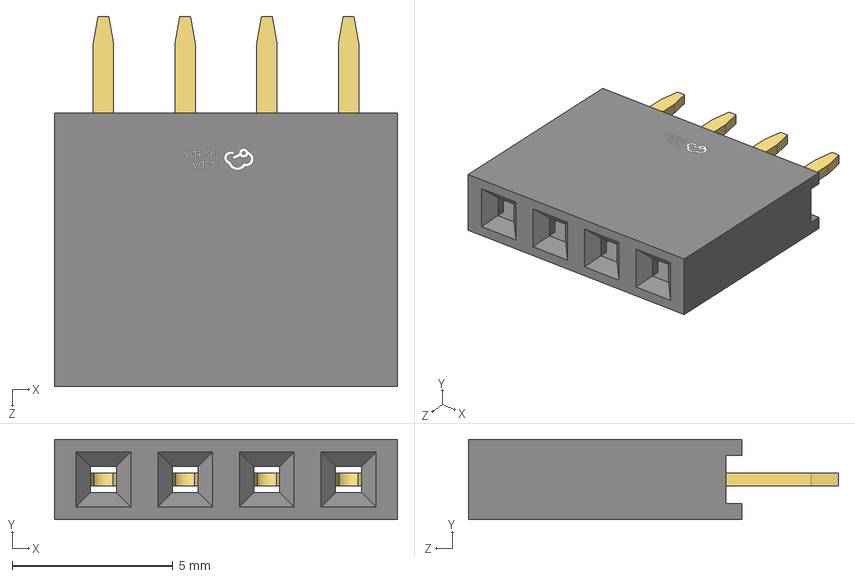
[picture p51: CAD file, 2026-11-10]
hardware/pcb/components/3d-models/HDR-TH_4P-P2.54-V-F.step
10.7 x 2.50 x 11.5 mm
