tothadi/esp-heating-control/hardware/pcb/components/3d-models/OLED-TH_L38.0-W12.0_HS91L02W2C01.step

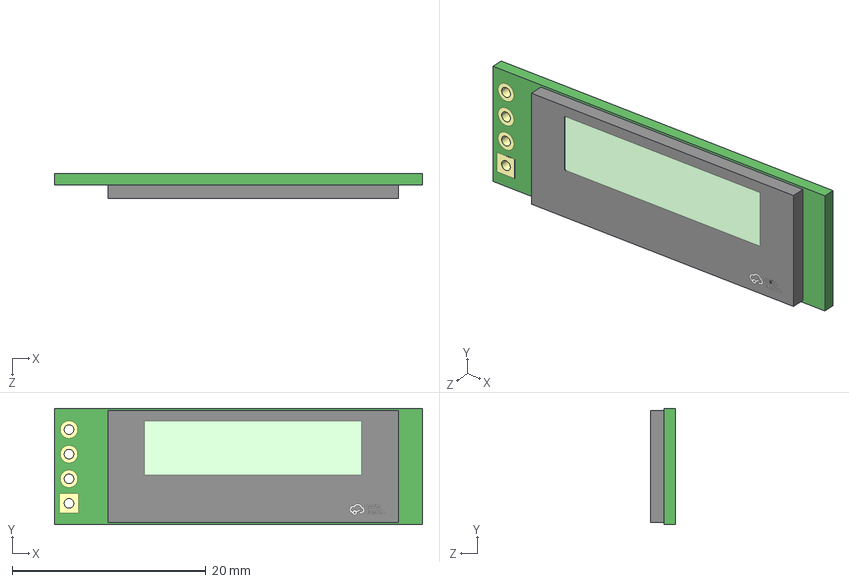
[picture p52: CAD file, 2026-11-10]
hardware/pcb/components/3d-models/OLED-TH_L38.0-W12.0_HS91L02W2C01.step
38.0 x 12.0 x 2.62 mm
