tothadi/esp-heating-control/hardware/pcb/components/3d-models/WIRELM-SMD_ESP32-S3-WROOM-1.step

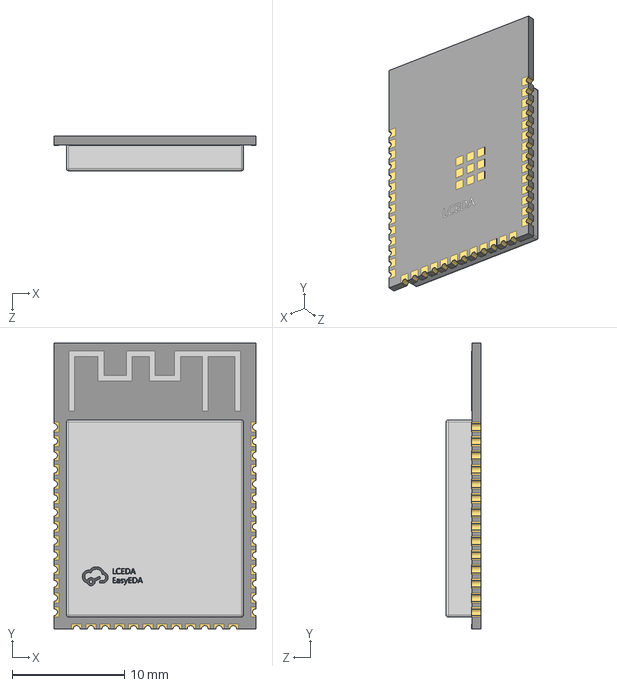
[picture p53: CAD file, 2026-11-10]
hardware/pcb/components/3d-models/WIRELM-SMD_ESP32-S3-WROOM-1.step
18.0 x 25.5 x 3.11 mm
