tothadi/esp-heating-control/hardware/pcb/components/3d-models/HDR-TH_4P-P2.54-M-LI-1X4P.step

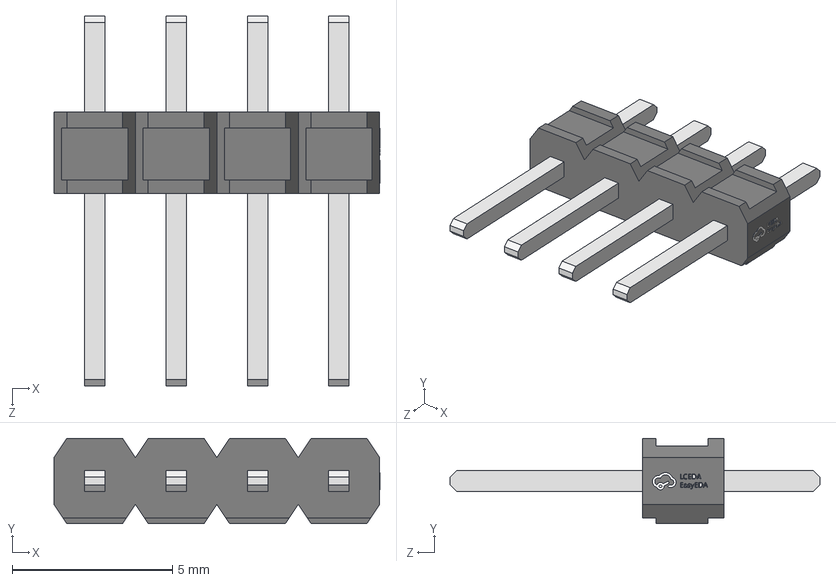
[picture p54: CAD file, 2026-11-10]
hardware/pcb/components/3d-models/HDR-TH_4P-P2.54-M-LI-1X4P.step
10.2 x 2.66 x 11.5 mm
