tothadi/esp-heating-control/hardware/pcb/components/3d-models/FPC-SMD_AFA07-S26FCA-00.step

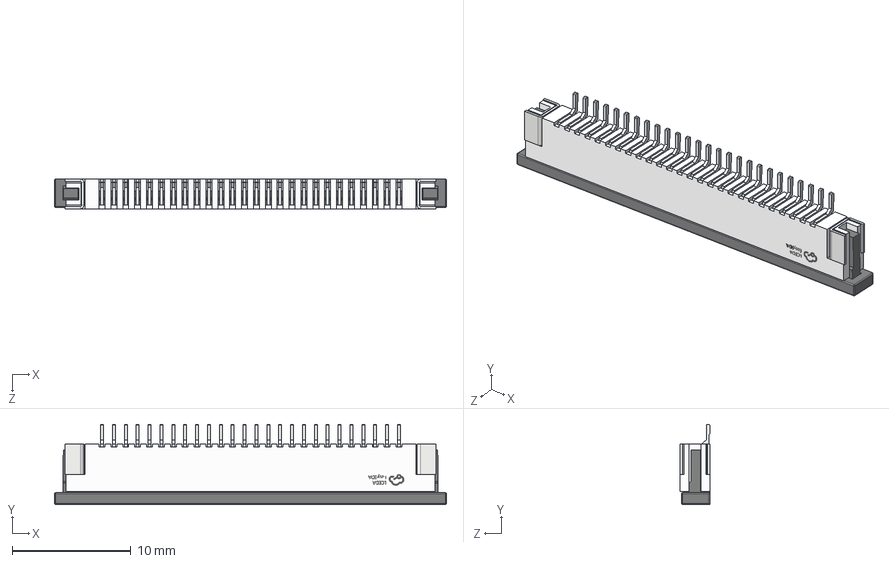
[picture p55: CAD file, 2026-11-10]
hardware/pcb/components/3d-models/FPC-SMD_AFA07-S26FCA-00.step
33.0 x 6.75 x 2.51 mm
