tothadi/esp-heating-control/hardware/pcb/components/3d-models/BAT-SMD_CR1220-2.step

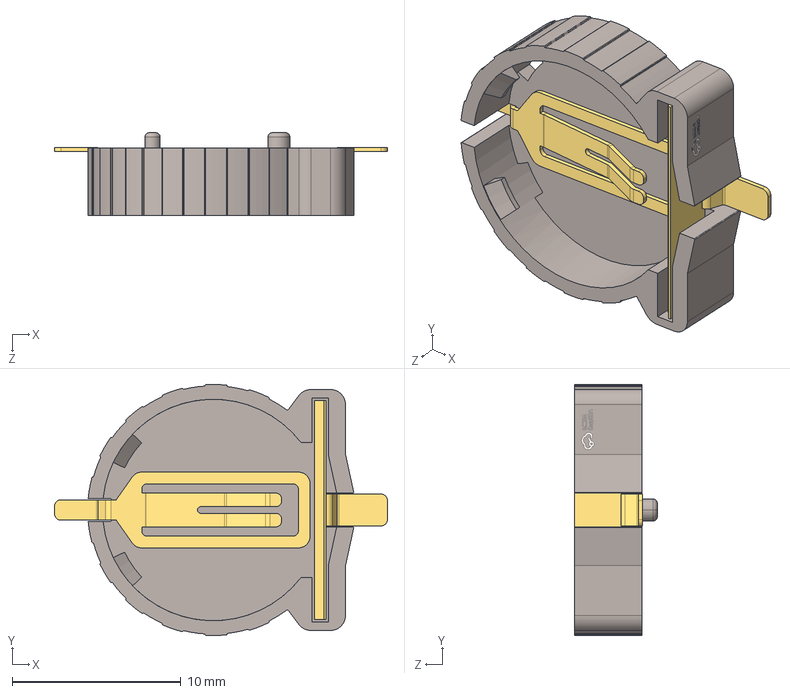
[picture p57: CAD file, 2026-11-10]
hardware/pcb/components/3d-models/BAT-SMD_CR1220-2.step
19.8 x 14.9 x 4.90 mm
