tothadi/esp-heating-control/hardware/pcb/components/3d-models/CONN-TH_2P-P5.08_DIBO_DB128V-5.08.step

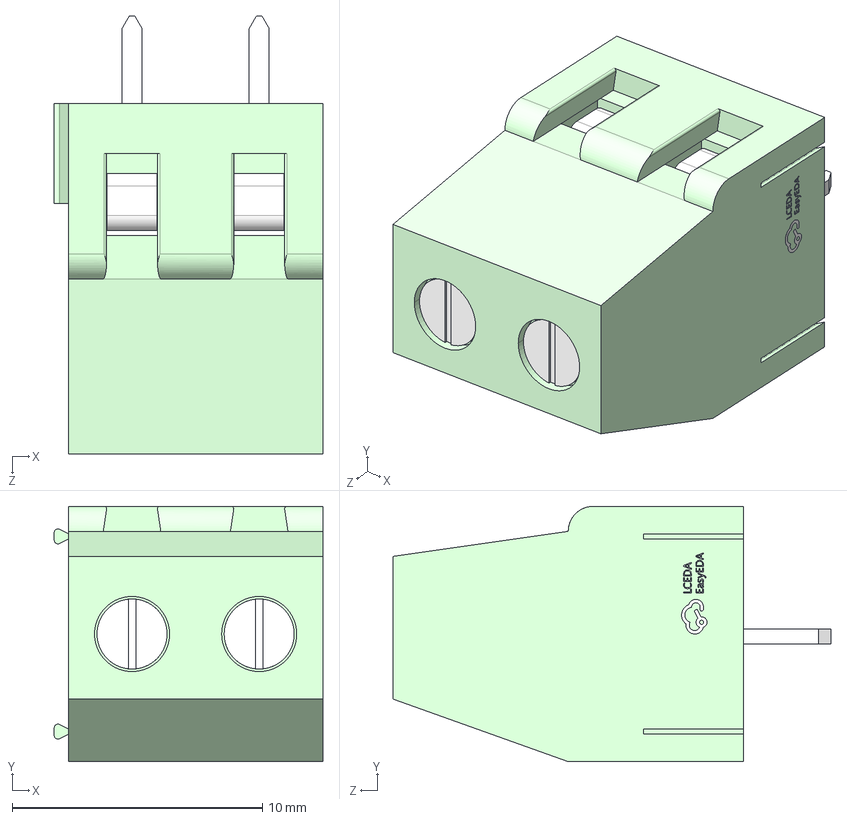
[picture p58: CAD file, 2026-11-10]
hardware/pcb/components/3d-models/CONN-TH_2P-P5.08_DIBO_DB128V-5.08.step
10.7 x 10.2 x 17.5 mm
