tothadi/esp-heating-control/hardware/pcb/components/3d-models/CONN-TH_4P-P3.50_KF2EDGR-3.5-4P.step

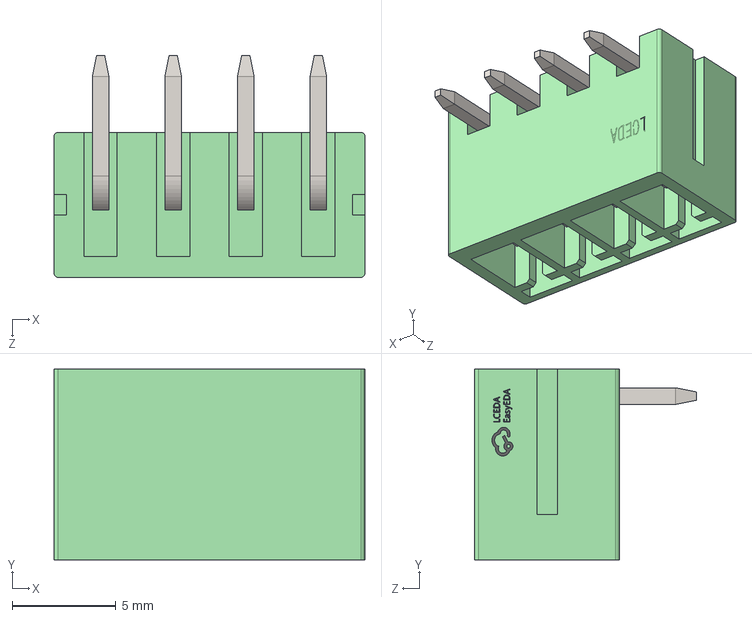
[picture p59: CAD file, 2026-11-10]
hardware/pcb/components/3d-models/CONN-TH_4P-P3.50_KF2EDGR-3.5-4P.step
15.0 x 9.20 x 10.7 mm
