tothadi/esp-heating-control/hardware/pcb/components/3d-models/OPTO-SMD-4_L4.6-W6.5-H3.6-LS10.2-P2.54.step

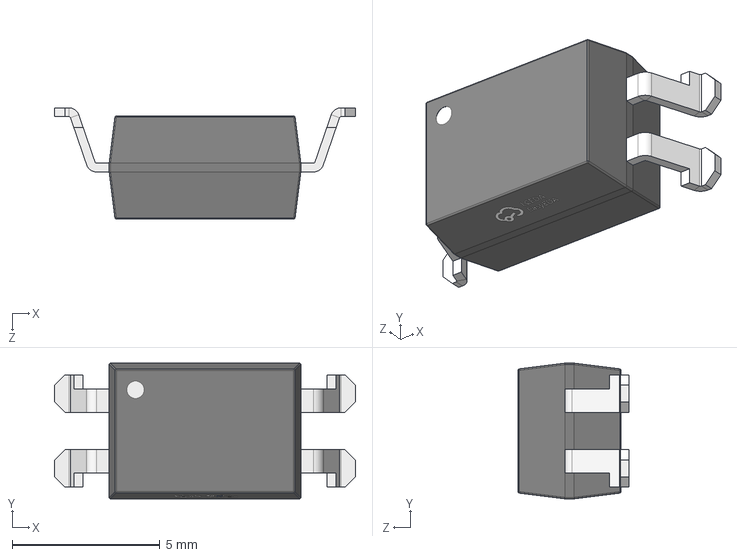
[picture p60: CAD file, 2026-11-10]
hardware/pcb/components/3d-models/OPTO-SMD-4_L4.6-W6.5-H3.6-LS10.2-P2.54.step
10.2 x 4.60 x 3.77 mm
