tothadi/esp-heating-control/hardware/pcb/components/3d-models/CONN-TH_3P-P3.50_KF2EDGR-3.5-3P.step

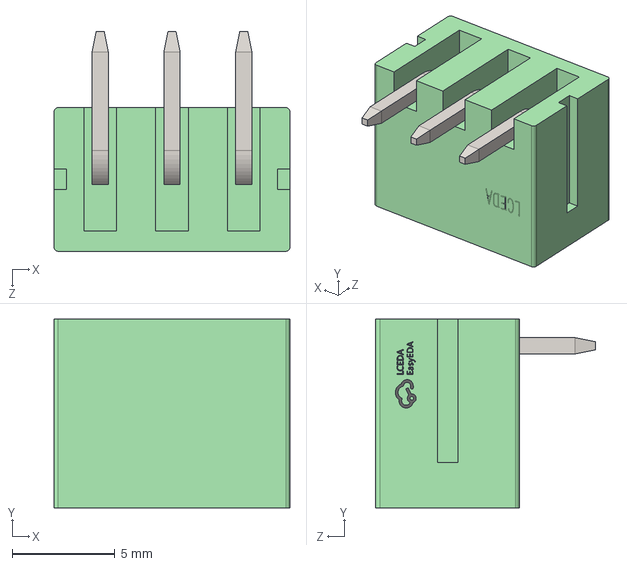
[picture p61: CAD file, 2026-11-10]
hardware/pcb/components/3d-models/CONN-TH_3P-P3.50_KF2EDGR-3.5-3P.step
11.5 x 9.20 x 10.7 mm
