tothadi/esp-heating-control/hardware/pcb/components/3d-models/CONN-TH_XY350V-3.5-2P.step

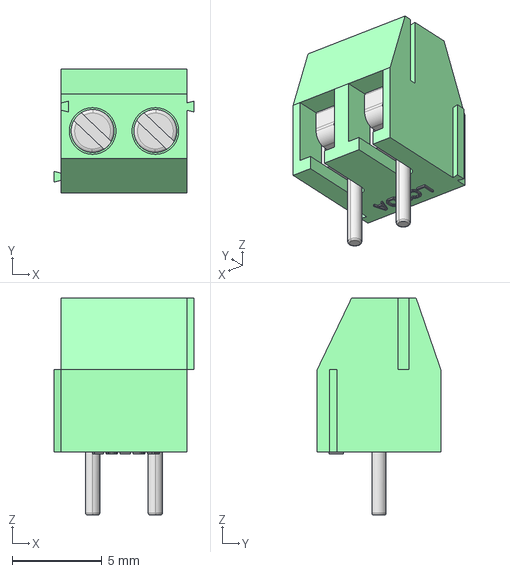
[picture p62: CAD file, 2026-11-10]
hardware/pcb/components/3d-models/CONN-TH_XY350V-3.5-2P.step
7.80 x 6.90 x 12.1 mm
