tothadi/esp-heating-control/hardware/pcb/components/3d-models/CONN-TH_DB5.08-WI-2P.step

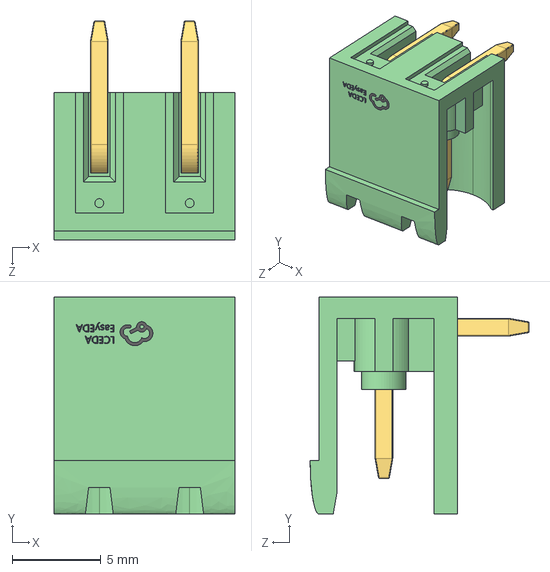
[picture p63: CAD file, 2026-11-10]
hardware/pcb/components/3d-models/CONN-TH_DB5.08-WI-2P.step
10.2 x 12.2 x 12.3 mm
