tothadi/esp-heating-control/hardware/pcb/components/3d-models/CONN-TH_8P-P5.08_DB128V-5.08-8P-GN-S.step

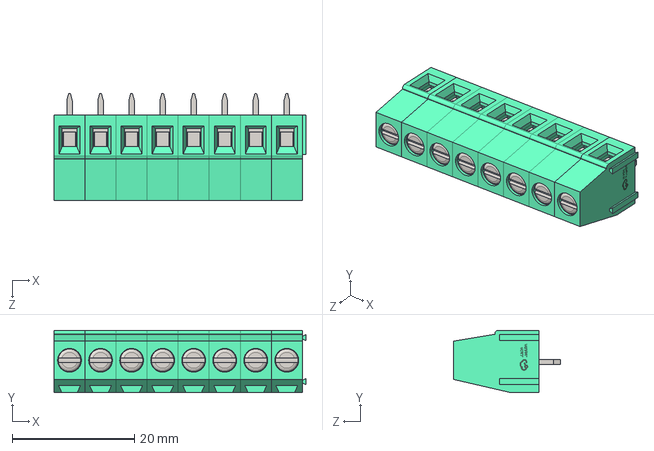
[picture p64: CAD file, 2026-11-10]
hardware/pcb/components/3d-models/CONN-TH_8P-P5.08_DB128V-5.08-8P-GN-S.step
41.2 x 10.2 x 17.5 mm
