tothadi/esp-heating-control/hardware/pcb/components/3d-models/IND-SMD_L4.0-W4.0-H2.0.step

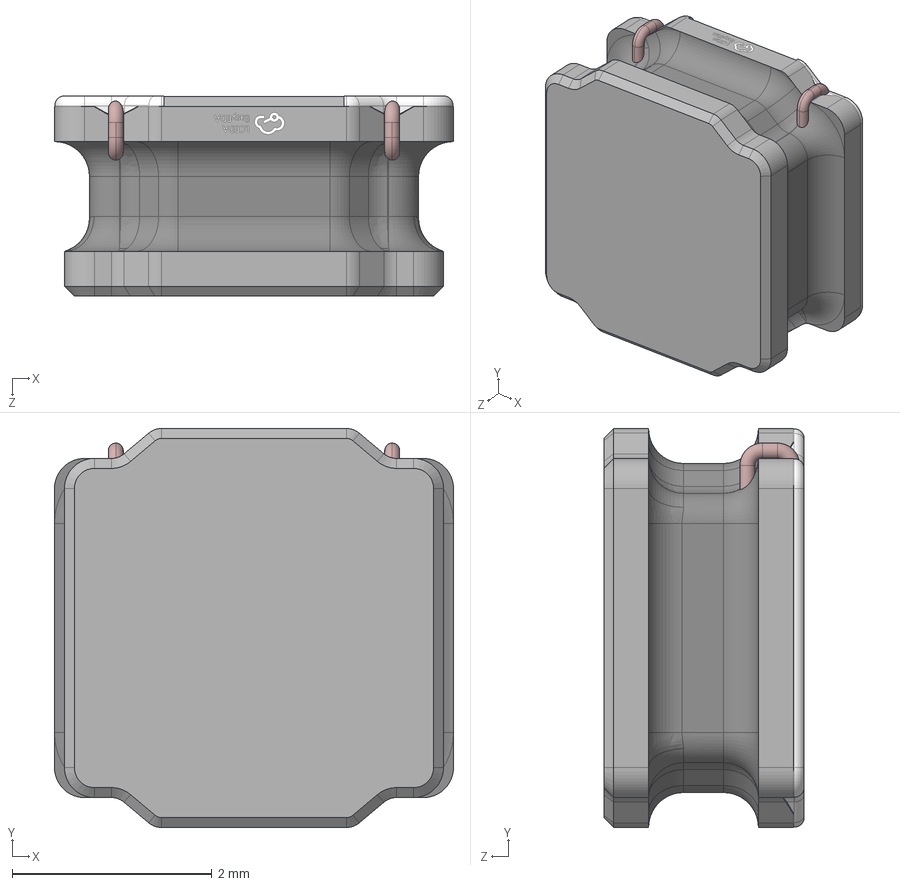
[picture p65: CAD file, 2026-11-10]
hardware/pcb/components/3d-models/IND-SMD_L4.0-W4.0-H2.0.step
4.00 x 4.00 x 2.01 mm
