tothadi/esp-heating-control/hardware/pcb/components/3d-models/CONN-TH_P3.50_KF2EDGR-3.5-2P.step

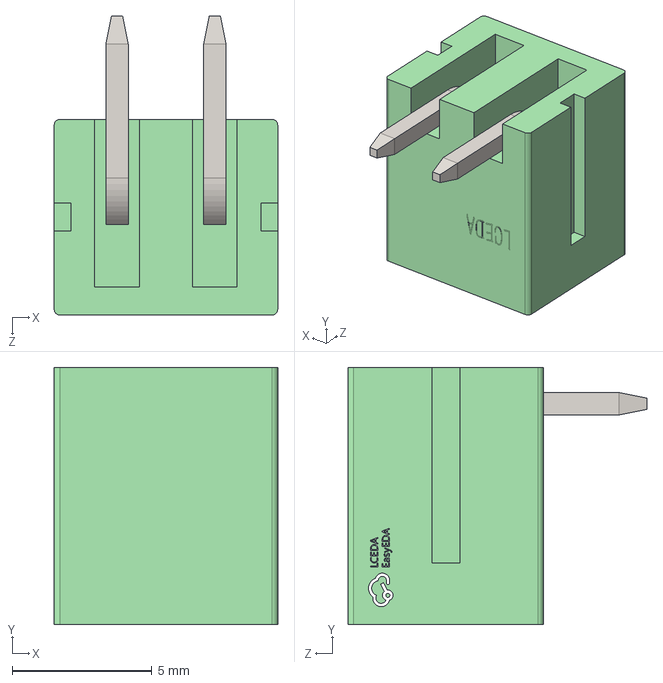
[picture p66: CAD file, 2026-11-10]
hardware/pcb/components/3d-models/CONN-TH_P3.50_KF2EDGR-3.5-2P.step
8.00 x 9.20 x 10.7 mm
