tothadi/esp-heating-control/hardware/pcb/components/3d-models/CONN-TH_4P-P5.08_KF2EDGR-5.08-4P.step

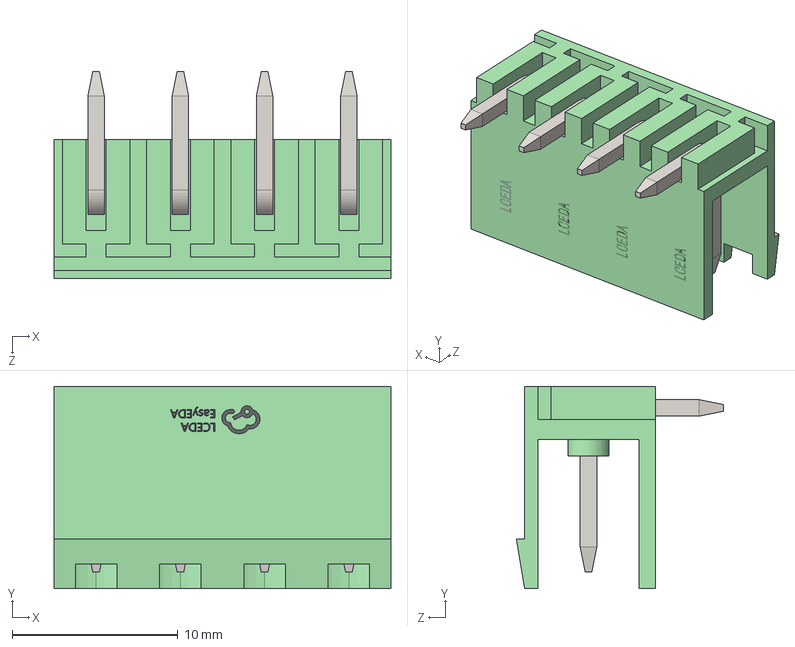
[picture p67: CAD file, 2026-11-10]
hardware/pcb/components/3d-models/CONN-TH_4P-P5.08_KF2EDGR-5.08-4P.step
20.3 x 12.2 x 12.5 mm
