tothadi/esp-heating-control/hardware/pcb/lower/lower.kicad_pcb

## KiCad design hardware/pcb/lower/lower.kicad_pcb (2026-11-10)

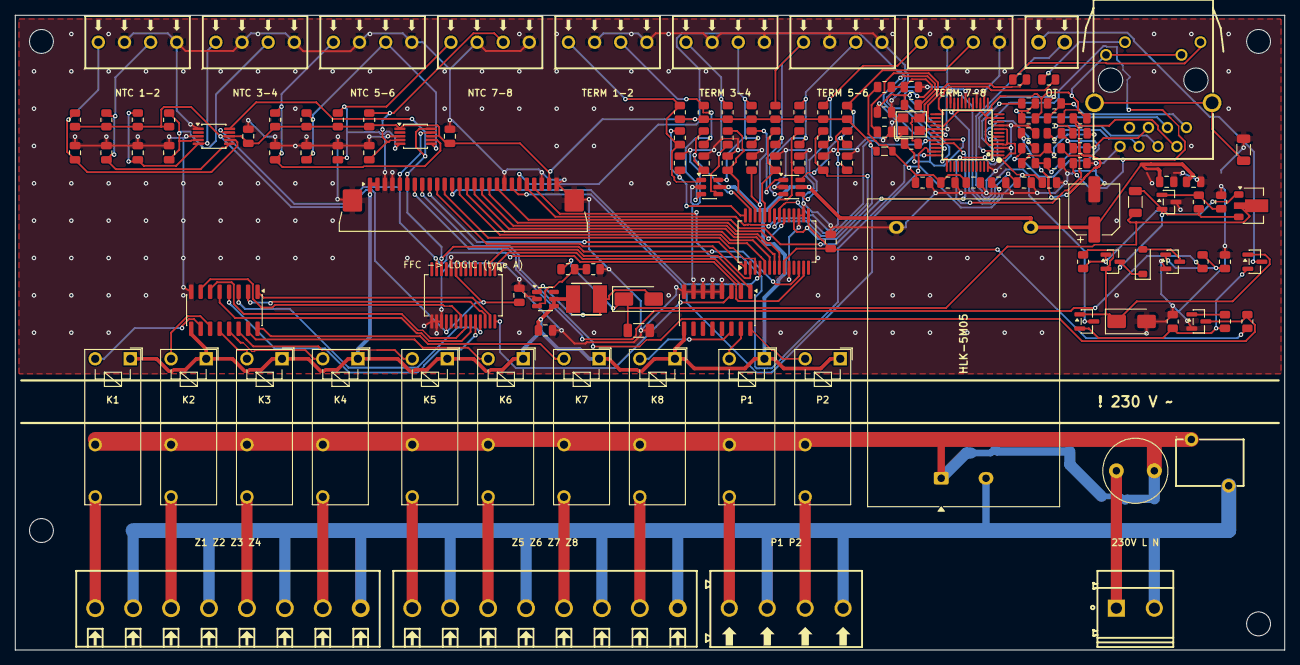
[picture p71: board lower.kicad_pcb from above]

Board: 2 copper layers, 170.0 x 85.0 mm, 144 parts (0 on the bottom side), 116 nets.

Parts:
C1, C4, C11, C19, C29, C30, C31, C32, C33, C34, C35, C36, C37, C73, C77, C80, C81, C82: 100nF 50V X7R; C_0805_2012Metric
C10, C21, C22, C23, C24, C25, C26, C27, C28, C40, C85: 10uF 25V X5R; C_0805_2012Metric
C12: 220uF 16V 6.3x7.7 (RVT1C221M0607); CP_Elec_6.3x7.7
C41: 10uF 50V X5R 1206; C_1206_3216Metric
C70: 22nF X7R 50V; C_0805_2012Metric
C71, C72: 6.8nF X7R 50V; C_0805_2012Metric
C74: 1nF 2kV X7R 1206; C_1206_3216Metric
C75, C76: 18pF C0G 50V; C_0805_2012Metric
C83: 10nF X7R 50V; C_0805_2012Metric
C84: 4.7uF X5R 25V; C_0805_2012Metric
D20: SS34; D_SMA
D21: BZT52C4V3; D_SOD-123
D22, D23: BAT54S; SOT-23
D24: SMAJ24A; D_SMA
F1: T2A; Fuse_Littelfuse_372_D8.50mm
FB1: Ferrite 600R@100MHz 500mA; L_0805_2012Metric
H1, H2, H3, H4: MountingHole_3.2mm_M3
J1, J2, J3, J4, J5, J6, J7, J8: XY350V-3.5-4P screw terminal; CONN-TH_XY350V-3.5-4P
J9: XY350V-3.5-2P screw terminal; CONN-TH_XY350V-3.5-2P
J21, J22: DB128V-5.08-8P-GN-S screw terminal; CONN-TH_8P-P5.08_DB128V-5.08-8P-GN-S
J23: DB128V-5.08-4P-GN-S screw terminal; CONN-TH_4P-P5.08_DIBO_DB128V-5.08
J24: DB128V-5.08-2P-GN-S screw terminal; CONN-TH_2P-P5.08_DIBO_DB128V-5.08
J30: AFA07-S26FCA-00; JUSHUO_AFA07-S26FCA-00_1x26-1MP_P1.0mm_Horizontal
J40: J1B1211CCD RJ45 10/100 magjack; RJ45-TH_J1B1211CCD
K1, K2, K3, K4, K5, K6, K7, K8, K9, K10: G5NB-1A-E-DC5V; Relay_SPST_Omron_G5NB
L1: 22uH SWPA4030S220MT; IND-SMD_L4.0-W4.0_SLW4010S
PS1: HLK-5M05; Converter_ACDC_Hi-Link_HLK-5Mxx
Q1: BCX56-16,115 (Nexperia); SOT-89-3
Q2, Q3, Q4: MMBT3904; SOT-23
R21, R22, R23, R24, R25, R26, R27, R28: 10k 0.1%; R_0805_2012Metric
R30, R31, R32, R33, R34, R35, R36, R37, R40, R41, R42, R43, R44, R45, R46, R47, R56, R59: 1k 1%; R_0805_2012Metric
R50: 390k 1%; R_0805_2012Metric
R51, R54, R57, R84: 10k 1%; R_0805_2012Metric
R52: 2.2k 1% 1206; R_1206_3216Metric
R53: 68k 1%; R_0805_2012Metric
R55: 15R 1%; R_0805_2012Metric
R58: 47R 1%; R_0805_2012Metric
R60: 4.7k 1%; R_0805_2012Metric
R70, R71, R75, R76: 3.3R 1%; R_0805_2012Metric
R72, R73, R77, R78: 49.9R 1%; R_0805_2012Metric
R74: 10R 1%; R_0805_2012Metric
R79: 12.4k 1%; R_0805_2012Metric
R80, R81: 470R 1%; R_0805_2012Metric
R82: 1M 1%; R_0805_2012Metric
R83: 0R; R_0805_2012Metric
RV1: 07D471K; RES-TH_L9.0-W6.2-P5.00-D0.7-S6.20
U1, U14: MCP23017-E/SS; SSOP-28_5.3x10.2mm_P0.65mm
U2, U3: ULN2003A; SOIC-16_3.9x9.9mm_P1.27mm
U10, U11: ADS1115IDGSR; MSOP-10_3x3mm_P0.5mm
U12, U13: SRV05-4; SOT-23-6
U20: MT3608; SOT-23-6
U21: CJ431; SOT-23
U30: W5500; LQFP-48_L7.0-W7.0-P0.50-LS9.0-BL
Y30: 25MHz 12pF X322525MOB4SI; CRYSTAL-SMD_4P-L3.2-W2.5-BL

Connections:
+3V3: C1.1, C4.1, C19.1, C29.1, FB1.1, J30.25, R21.1, R22.1, R23.1, R24.1, R25.1, R26.1, R27.1, R28.1, R30.1, R31.1, R32.1, R33.1, R34.1, R35.1, R36.1, R37.1, R60.1, U1.9, U1.18, U10.8, U11.1, U11.8, U14.9, U14.15, U14.18
+3V3E: C80.1, C81.1, C82.1, C85.1, FB1.2, J40.10, J40.12, R72.2, R73.2, R74.2, R84.1, U30.4, U30.8, U30.11, U30.15, U30.17, U30.21, U30.28
+5V: C10.1, C11.1, C12.1, C40.1, J30.1, J30.2, K1.A1, K2.A1, K3.A1, K4.A1, K5.A1, K6.A1, K7.A1, K8.A1, K9.A1, K10.A1, L1.1, PS1.4, U2.9, U3.9, U12.5, U13.5, U20.4, U20.5
+24V: C41.1, D20.1, Q1.2, R50.1, R52.1
CHGND: C74.1, J40.13, J40.14
COIL1: K1.A2, U2.10
COIL2: K2.A2, U2.11
COIL3: K3.A2, U2.12
COIL4: K4.A2, U2.13
COIL5: K5.A2, U2.14
COIL6: K6.A2, U2.15
COIL7: K7.A2, U2.16
COIL8: K8.A2, U3.14
COIL9: K9.A2, U3.15
COIL10: K10.A2, U3.16
ETH_1V2O: C83.1, U30.22
ETH_ACT: R81.2, U30.27
ETH_CS: J30.22, U30.32
ETH_EXRES: R79.1, U30.10
ETH_GLEDK: J40.9, R81.1
ETH_INT: J30.23, U30.36
ETH_LINK: R80.2, U30.25
ETH_MISO: J30.21, U30.34
ETH_MOSI: J30.20, U30.35
ETH_RDN: C71.1, J40.6
ETH_RDP: C72.1, J40.4
ETH_RST: C77.1, R84.2, U30.37
ETH_RXCM: C73.1, J40.5, R77.2, R78.2
ETH_RXN: R75.2, U30.5
ETH_RXN_M: C71.2, R75.1, R77.1
ETH_RXP: R76.2, U30.6
ETH_RXP_M: C72.2, R76.1, R78.1
ETH_SCK: J30.18, U30.33
ETH_TCT: C70.1, J40.2, R74.1
ETH_TDN: J40.3, R70.2, R72.1
ETH_TDP: J40.1, R71.2, R73.1
ETH_TOCAP: C84.1, U30.20
ETH_TXN: R70.1, U30.1
ETH_TXP: R71.1, U30.2
ETH_XI: C75.1, R82.1, U30.30, Y30.1
ETH_XO: R82.2, R83.1, U30.31
ETH_XO2: C76.1, R83.2, Y30.3
ETH_YLEDK: J40.11, R80.1
FB: R50.2, R51.1, U20.3
GND: C1.2, C4.2, C10.2, C11.2, C12.2, C19.2, C21.2, C22.2, C23.2, C24.2, C25.2, C26.2, C27.2, C28.2, C29.2, C30.2, C31.2, C32.2, C33.2, C34.2, C35.2, C36.2, C37.2, C40.2, C41.2, C70.2, C73.2, C74.2, C75.2, C76.2, C77.2, C80.2, C81.2, C82.2, C83.2, C84.2, C85.2, D24.2, J1.2, J1.4, J2.2, J2.4, J3.2, J3.4, J4.2, J4.4, J5.2, J5.4, J6.2, J6.4, J7.2, J7.4, J8.2, J8.4, J30.3, J30.4, J30.19, J30.24, J30.26, J30.MP, J40.8, PS1.3, Q3.2, Q4.2, R51.2, R54.2, R57.2, R58.2, R79.2, U1.10, U1.15, U1.16, U1.17, U2.8, U3.4, U3.5, U3.6, U3.7, U3.8, U10.1, U10.3, U11.3, U12.2, U13.2, U14.10, U14.16, U14.17, U20.2, U21.3, U30.3, U30.9, U30.14, U30.16, U30.19, U30.23, U30.29, U30.48, Y30.2, Y30.4
LEDZ1: J30.9, U14.1
LEDZ2: J30.10, U14.2
LEDZ3: J30.11, U14.3
LEDZ4: J30.12, U14.4
LEDZ5: J30.13, U14.5
LEDZ6: J30.14, U14.6
LEDZ7: J30.15, U14.7
LEDZ8: J30.16, U14.8
LOUT1: J21.1, K1.14
LOUT2: J21.3, K2.14
LOUT3: J21.5, K3.14
LOUT4: J21.7, K4.14
LOUT5: J22.1, K5.14
LOUT6: J22.3, K6.14
LOUT7: J22.5, K7.14
LOUT8: J22.7, K8.14
LOUT9: J23.1, K9.14
LOUT10: J23.3, K10.14
L_F: F1.2, K1.13, K2.13, K3.13, K4.13, K5.13, K6.13, K7.13, K8.13, K9.13, K10.13, PS1.1, RV1.1
L_IN: F1.1, J24.1
MCP_INT: J30.17, U14.20
NTC1: C21.1, J1.1, R21.2, U10.7
NTC2: C22.1, J1.3, R22.2, U10.6
NTC3: C23.1, J2.1, R23.2, U10.5
NTC4: C24.1, J2.3, R24.2, U10.4
NTC5: C25.1, J3.1, R25.2, U11.7
NTC6: C26.1, J3.3, R26.2, U11.6
NTC7: C27.1, J4.1, R27.2, U11.5
NTC8: C28.1, J4.3, R28.2, U11.4
N_AC: J21.2, J21.4, J21.6, J21.8, J22.2, J22.4, J22.6, J22.8, J23.2, J23.4, J24.2, PS1.2, RV1.2
OT_A: D22.3, J9.1
OT_B: D23.3, J9.2
OT_BASE: D21.1, Q1.3, Q2.3, R52.2, R53.1, U21.2
OT_E: Q1.1, Q2.1, R55.1
OT_LINE: D22.1, D23.1, D24.1, Q2.2, R55.2
OT_LOW: D21.2, Q3.3
OT_REF: R53.2, R54.1, U21.1
OT_RET: D22.2, D23.2, R58.1, R59.1
OT_RX: J30.8, Q4.3, R60.2
OT_RXB: Q4.1, R59.2
OT_TX: J30.7, R56.1
OT_TXB: Q3.1, R56.2, R57.1
RIN1: U1.21, U2.7
RIN2: U1.22, U2.6
RIN3: U1.23, U2.5
RIN4: U1.24, U2.4
RIN5: U1.25, U2.3
RIN6: U1.26, U2.2
RIN7: U1.27, U2.1
RIN8: U1.28, U3.3
RIN9: U1.1, U3.2
RIN10: U1.2, U3.1
SCL: J30.6, U1.12, U10.10, U11.10, U14.12
SDA: J30.5, U1.13, U10.9, U11.9, U14.13
SW_BOOST: D20.2, L1.2, U20.1
TIN1: J5.1, R30.2, R40.1, U12.1
TIN2: J5.3, R31.2, R41.1, U12.3
TIN3: J6.1, R32.2, R42.1, U12.4
TIN4: J6.3, R33.2, R43.1, U12.6
TIN5: J7.1, R34.2, R44.1, U13.1
TIN6: J7.3, R35.2, R45.1, U13.3
TIN7: J8.1, R36.2, R46.1, U13.4
TIN8: J8.3, R37.2, R47.1, U13.6
TINF1: C30.1, R40.2, U14.28
TINF2: C31.1, R41.2, U14.27
TINF3: C32.1, R42.2, U14.26
TINF4: C33.1, R43.2, U14.25
TINF5: C34.1, R44.2, U14.24
TINF6: C35.1, R45.2, U14.23
TINF7: C36.1, R46.2, U14.22
TINF8: C37.1, R47.2, U14.21
