tothadi/esp-heating-control/hardware/pcb/logic/logic_routed.kicad_pcb

## KiCad design hardware/pcb/logic/logic_routed.kicad_pcb (2026-11-10)

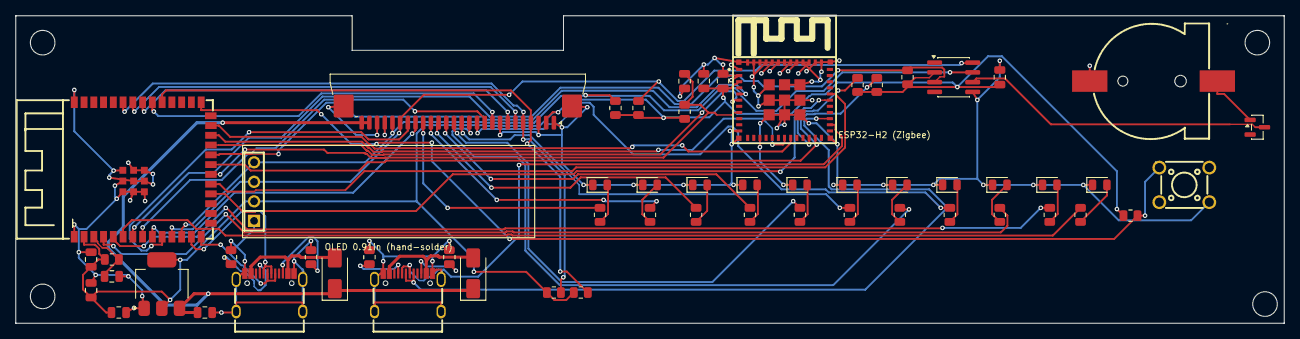
[picture p72: board logic_routed.kicad_pcb from above]

Board: 2 copper layers, 165.0 x 40.0 mm, 62 parts (0 on the bottom side), 59 nets.

Parts:
BT1: BS-12-B2AA002 (CR1220); BAT-SMD_BS-12-B2AA002
C40, C41, C48: 10uF 25V X5R; C_0805_2012Metric
C43, C45, C49: 100nF 50V X7R; C_0805_2012Metric
C44, C50: 1uF 50V X7R; C_0805_2012Metric
C47: 22uF 25V X5R; C_0805_2012Metric
D1, D2: SS34; D_SMA
D14: BAT54S; SOT-23
D20, D21, D22, D23, D24, D25, D26, D27: LED green 0805; LED_0805_2012Metric
D28, D29: LED yellow 0805; LED_0805_2012Metric
D30: LED red 0805; LED_0805_2012Metric
H1, H2, H3, H4: MountingHole_3.2mm_M3
J1: AFA07-S26FCA-00; JUSHUO_AFA07-S26FCA-00_1x26-1MP_P1.0mm_Horizontal
J2, J4: TYPE-C-31-M-12; USB-C_SMD-TYPE-C-31-M-12_1
J3: PZ254V-11-04P pin header 1x4 2.54mm (OLED); HDR-TH_4P-P2.54-V-M
R9, R10, R28, R29: 4.7k 1%; R_0805_2012Metric
R17, R19, R20, R25, R26, R27: 10k 1%; R_0805_2012Metric
R21, R22, R23, R24: 5.1k 1%; R_0805_2012Metric
R50, R51, R52, R53, R54, R55, R56, R57, R58, R59, R60: 330R 1%; R_0805_2012Metric
SW1: KH-6X6X13H-TJ; SW-TH_4P-L6.0-W6.0-P4.50-LS6.5
U1: ESP32-S3-WROOM-1-N16R8; WIRELM-SMD_ESP32-S3-WROOM-1
U2: AMS1117-3.3; SOT-223-3_TabPin2
U6: DS3231MZ+TRL; SOIC-8_3.9x4.9mm_P1.27mm
U7: ESP32-H2-MINI-1-H4S; WIRELM-SMD_ESP32-H2-MINI-1-H4

Connections:
+3V3: C41.1, C43.1, C45.1, C47.1, C48.1, C49.1, J1.2, J3.2, R9.1, R10.1, R17.1, R19.1, R20.1, R25.1, R26.1, R27.1, R28.1, R29.1, U1.2, U2.2, U6.2, U7.3
+5V: C40.1, D1.1, D2.1, J1.25, J1.26, U2.3
BATP: BT1.1, D14.1
BTN: R19.2, SW1.1, U1.27
CC1: J2.A5, R21.1
CC2: J2.B5, R22.1
CC3: J4.A5, R23.1
CC4: J4.B5, R24.1
EN: C44.1, R17.2, U1.3
ETH_CS: J1.5, R28.2, U1.35
ETH_INT: J1.4, R29.2, U1.31
ETH_MISO: J1.6, U1.34
ETH_MOSI: J1.7, U1.33
ETH_SCK: J1.9, U1.32
GND: BT1.2, C40.2, C41.2, C43.2, C44.2, C45.2, C47.2, C48.2, C49.2, C50.1, D20.1, D21.1, D22.1, D23.1, D24.1, D25.1, D26.1, D27.1, D28.1, D29.1, D30.1, J1.1, J1.3, J1.8, J1.23, J1.24, J1.MP, J2.1, J2.2, J2.3, J2.4, J2.A1B12, J2.B1A12, J3.1, J4.1, J4.2, J4.3, J4.4, J4.A1B12, J4.B1A12, R21.2, R22.2, R23.2, R24.2, SW1.4, U1.1, U1.40, U1.41, U2.1, U6.5, U7.1, U7.2, U7.11, U7.14, U7.36, U7.37, U7.38, U7.39, U7.40, U7.41, U7.42, U7.43, U7.44, U7.45, U7.46, U7.47, U7.48, U7.49, U7.50, U7.51, U7.52, U7.53
H2_BOOT: R27.2, U1.21, U7.23
H2_EN: C50.2, R25.2, U1.20, U7.8
H2_IO8: R26.2, U7.22
H2_RXD: U1.18, U7.30
H2_TXD: U1.19, U7.31
LEDA1: D20.2, R50.1
LEDA2: D21.2, R51.1
LEDA3: D22.2, R52.1
LEDA4: D23.2, R53.1
LEDA5: D24.2, R54.1
LEDA6: D25.2, R55.1
LEDA7: D26.2, R56.1
LEDA8: D27.2, R57.1
LEDA9: D28.2, R58.1
LEDA10: D29.2, R59.1
LEDA11: D30.2, R60.1
LEDZ1: J1.18, R50.2
LEDZ2: J1.17, R51.2
LEDZ3: J1.16, R52.2
LEDZ4: J1.15, R53.2
LEDZ5: J1.14, R54.2
LEDZ6: J1.13, R55.2
LEDZ7: J1.12, R56.2
LEDZ8: J1.11, R57.2
LED_P1: R58.2, U1.4
LED_P2: R59.2, U1.5
LED_ST: R60.2, U1.6
MCP_INT: J1.10, U1.8
OT_RX: J1.19, U1.9
OT_TX: J1.20, U1.10
PTA1: U1.22, U7.5
PTA2: U1.23, U7.6
PTA3: U1.24, U7.18
PTA4: U1.25, U7.19
RTC_INT: R20.2, U1.7, U6.3
SCL: J1.21, J3.3, R10.2, U1.11, U6.8
SDA: J1.22, J3.4, R9.2, U1.12, U6.7
USB2_DN: J4.A7, J4.B7, U7.26
USB2_DP: J4.A6, J4.B6, U7.27
USB_DN: J2.A7, J2.B7, U1.13
USB_DP: J2.A6, J2.B6, U1.14
VBAT: D14.3, U6.6
VBUS: D1.2, J2.A4B9, J2.B4A9
VBUS2: D2.2, J4.A4B9, J4.B4A9
