tothadi/esp-heating-control/(commit log)

2026-11-10 Rework hardware for ESP32-S3 + H2 and Ethernet, add firmware variants, restructure repo
    Hardware
    - Logic board: ESP32-S3-WROOM-1-N16R8 replaces the ESP32-C6; ESP32-H2-MINI-1
    co-processor (Zigbee / Thread RCP) with its own USB-C; two USB-C ports side by
    side ("MAIN" / "RADIO"); OLED, LEDs and button aligned to the OLED active area;
    4 mounting holes for threaded inserts
    - Power/IO board: W5500 10/100 Ethernet with RJ45 ("LAN"), FFC pins 18-24 for SPI;
    all terminals face outwards (pump terminals flipped), top row moved for the H1
    insert, 1.0 mm block gaps; RV1/F1 3D models fixed
    - Both boards rerouted, DRC clean; Gerbers, BOM/CPL and renders regenerated
    Enclosure
    - SLA resin (CBY) in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
    [BAT-SMD_BS-12-B2AA002.step, BAT-SMD_CR1220-2.step, BAT-SMD_L28.5-W16.0-H5.5-LS31.3_CR2032-BS-6-1.step, CONN-TH_2P-P5.08_DIBO_DB128V-5.08.step, CONN-TH_3P-P3.50_KF2EDGR-3.5-3P.step, CONN-TH_4P-P3.50_KF2EDGR-3.5-4P.step, CONN-TH_4P-P5.08_DIBO_DB128V-5.08.step, CONN-TH_4P-P5.08_KF2EDGR-5.08-4P.step]
2026-11-12 Extend cooling plan: wireless mixing valve, separate ceiling circuits
    - Add option D: Zigbee/Matter mixing valve actuator, driven by the same
    PI loop as the 3-point valve, so no relay is needed. Zigbee needs a
    new S3 -> H2 write command; both firmwares get a fail safe for an
    unreachable actuator.
    - Support floor heating with separate ceiling cooling circuits only
    with Zigbee/Matter thermal actuators: virtual "Ceiling, cool only"
    zones with a room link, confirmed switching, and cooling stops for
    the whole ceiling circuit when an actuator is unreachable.
    - Update phases, API, risks and open questions accordingly.
